yukinoshitaworks/pendulum-clock/cad/README.md

# おもり式 振り子時計 — CADデータ

HTMLシミュレーターと同じ設計スクリプトから書き出したデータです。シミュレーターに映っている形状は、このCADを三角形メッシュにしたものです。

**実機での動作は未確認です。** 歯のかみ合い・部品同士の干渉・脱進機の動きは計算で確認していますが、はめあいの公差、摩擦、おもりの重さは印刷後の調整が前提です。

## 中身

- `pendulum_clock_assembly.step` — 組立状態の全体モデル（12:00:00、鐘を打った直後の姿勢）。部品名つき。Fusion の「アップロード」または「挿入」で開けます。約22 MBあります。
- `parts_step/` — 印刷部品ごとのSTEP（印刷する向きで、底面が Z=0）
- `parts_stl/` — 同じ向きのSTL。そのままスライサーに入れられます
- `extras/anchor_deep_0.2` `anchor_deep_0.4` `anchor_shallow_0.2`（`.step` `.stl`）— 深さ違いのアンクル。脱進機が空回りするときは deep、引っかかって止まるときは shallow に替える（10月28日の節）。
- `extras/fit_test_coupon.step` `.stl` — 穴の試し刷り用の板（圧入穴 φ3.35〜3.55、ベアリングのポケット φ10.30〜10.50 を5段ずつ、径を彫ってある）。本番の前に刷って、ちょうどよい径を選ぶ
- `source/` — 生成に使った Python（CadQuery）スクリプト。歯数や寸法を変えて再生成できます。`fit_test.py` は試し刷り用の板を作る

## 主な仕様

| 項目 | 値 |
|---|---|
| 振り子 | 周期 1 秒（支点から振り玉中心まで約 250 mm、ナットで調整） |
| 脱進機 | グラハム式デッドビート、ガンギ車 30 枚（先端径 60 mm）、7.5 歯またぎ、リフト 1.5°／ロック 1.5°／ドロップ 2.75°（歯先の幅 0.8 mm、前の面の逃げ 12°、歯の背に段） |
| 輪列 | 一番車 60 → カナ 24、二番車 96 → カナ 8、三番車 80 → ガンギカナ 8（インボリュート、圧力角 20°、m1.5 / m1.0） |
| 日の裏 | 筒カナ 12 → 日の裏車 36、カナ 10 → 筒車 40（m1.0 / m0.96） |
| 動力 | 巻胴 φ47、2.5 時間で 1 回転。ひも約 9.8 巻きで約 24.5 時間（毎日巻く）、降下量 約 1.49 m。おもり 1〜1.5 kg |
| 鐘 | 二番軸の渦巻きカムがハンマーを 1 時間かけて持ち上げ、正時に 1 回打つ（時の数は打ち分けません） |
| 地板間 | 36 mm、地板厚 5 mm |

## 印刷部品（36 種、合計 約 463 cm³）

最大の部品は `back_plate`（166 × 198 mm）で、220 × 220 mm のベッドに収まります。おもり容器は高さ 200 mm です。

| ファイル | 部品 | 個数 | 寸法 mm | 体積 cm³ |
|---|---|---|---|---|
| `back_plate` | 後ろ地板（ベル支柱つき） | 1 | 166 × 198 × 42 | 58 |
| `front_plate` | 前地板 | 1 | 131 × 198 × 5 | 47 |
| `pillar_36_x4` | 地板間ピラー (36 mm) | 4 | 10 × 10 × 36 | 2 |
| `rear_standoff_30_x4` | 背面スタンドオフ (30 mm) | 4 | 10 × 10 × 30 | 2 |
| `front_spacer_16_x2` | 上側の前スペーサ (16.2 mm)（M3 全ねじ 100 mm の余りを受ける） | 2 | 10 × 10 × 16 | 1 |
| `wall_frame` | 壁掛けフレーム | 1 | 131 × 176 × 6 | 46 |
| `great_wheel` | 一番車 60枚 (m1.5) | 1 | 93 × 93 × 14 | 25 |
| `click_plate` | コハゼ板（一体ばね爪×3） | 1 | 59 × 59 × 10 | 7 |
| `drum_core` | 巻胴（ラチェットつき） | 1 | 55 × 55 × 17 | 25 |
| `drum_front` | 巻胴 前フランジ（六角巻き軸） | 1 | 55 × 55 × 22 | 8 |
| `centre_wheel` | 二番車 96枚＋カナ24枚 | 1 | 97 × 97 × 22 | 25 |
| `spacer_C_rear` | スペーサ 1.7 mm | 1 | 5 × 5 × 2 | 0 |
| `strike_cam` | 打鐘カム（1時間で1回転の渦巻き） | 1 | 27 × 23 × 12 | 3 |
| `third_wheel` | 三番車 80枚＋カナ8枚 | 1 | 81 × 81 × 20 | 10 |
| `spacer_T_front` | スペーサ 15.2 mm | 1 | 5 × 5 × 15 | 0 |
| `escape_wheel` | ガンギ車 30枚＋カナ8枚 | 1 | 60 × 60 × 27 | 6 |
| `spacer_E_rear` | スペーサ 8.7 mm | 1 | 5 × 5 × 9 | 0 |
| `anchor` | アンクル（グラハム式デッドビート） | 1 | 60 × 29 × 27 | 4 |
| `spacer_A_rear` | スペーサ 8.2 mm | 1 | 5 × 5 × 8 | 0 |
| `cannon_pinion` | 筒カナ 12枚（摩擦で軸に固定） | 1 | 14 × 14 × 22 | 1 |
| `minute_wheel` | 日の裏車 36枚＋カナ10枚 | 1 | 37 × 37 × 11 | 4 |
| `collar_x2` | 抜け止めカラー | 2 | 7 × 7 × 3 | 0 |
| `hour_wheel` | 筒車 40枚（時針） | 1 | 40 × 40 × 12 | 4 |
| `minute_hand` | 長針 | 1 | 13 × 98 × 2 | 1 |
| `hour_hand` | 短針 | 1 | 16 × 67 × 2 | 1 |
| `dial_ring` | 文字盤リング | 1 | 176 × 176 × 4 | 28 |
| `dial_standoff_12_x2` | 文字盤スタンドオフ (12 mm) | 2 | 10 × 10 × 12 | 1 |
| `dial_post_top` | 文字盤ポスト 12時側 (下穴φ2.8) | 1 | 8 × 8 × 12 | 0 |
| `hammer` | ハンマー（尾がカムに乗る） | 1 | 87 × 52 × 12 | 4 |
| `pendulum_hanger_left` | 振り子ハンガー 左半分（ねじの頭の側） | 1 | 17 × 41 × 8 | 5 |
| `pendulum_hanger_right` | 振り子ハンガー 右半分（ナットの側） | 1 | 17 × 41 × 8 | 5 |
| `bob_rear` | 振り玉 φ70 後ろ半分（ピンつき・接着） | 1 | 70 × 70 × 10 | 26 |
| `bob_front` | 振り玉 φ70 前半分（接着） | 1 | 70 × 70 × 8 | 23 |
| `rating_nut` | 歩度調整ナット（M4ナット内蔵） | 1 | 18 × 18 × 9 | 2 |
| `weight_shell` | おもり容器 φ50×200（鉄球などを充填） | 1 | 50 × 50 × 200 | 65 |
| `winding_key` | 巻きカギ（六角10 mm） | 1 | 60 × 19 × 29 | 10 |

印刷の目安: ノズル 0.4 mm、積層 0.2 mm（歯車は 0.12〜0.16 mm が無難）、外周 3 周以上。歯車と脱進機まわりは反りの少ない PLA、コハゼ板（ばね爪）は折れにくい PETG を推奨。サポートは不要な向きにしてあります（振り玉とハンガーは横穴のサポートが取りにくかったため、10月17日に前後2つに分けました）。巻胴の後ろフランジ裏だけ約 54° の張り出しがあります。

## 別途用意するもの

| 品目 | 数量 | 用途 |
|---|---|---|
| ミニチュアベアリング 623ZZ（3×10×4） | 8 | 二番・三番・ガンギ・アンクルの各軸。グリスは洗い流して軽い油を一滴。購入先の例：[Amazon](https://amzn.asia/d/0f9G3Mzo) |
| φ3 丸棒（ステンレスか磨き鋼、5 mm 刻みの定尺品） | 70 / 65 / 55 / 55 / 45 / 45 / 20 / 20 mm 各1 | 順に 二番軸、アンクル軸、一番軸、おもりのひも掛け（50 mm でも可）、三番軸、ガンギ軸、ハンマー軸、日の裏車の軸。切断不要 |
| M3 全ねじ | 100 mm ×4 | 壁フレーム〜地板（下2本は文字盤まで）を通しで締める。上2本は前に上側の前スペーサを通す |
| M3 ナット | 8 | 上記の両端（壁側は六角ポケットに入れる） |
| M3×12 皿タッピング | 3 | 巻胴の前後をつなぐ（下穴 φ3.1） |
| M3×10 皿ねじ | 2 | 文字盤 12 時側ポストの前後 |
| M3×20 ＋ナット | 3 | 振り子ハンガーの左右を締めて、アンクル軸と振り竿をはさむ |
| M4 全ねじ 285 mm ＋ M4 ナット 2 | 1 | 振り竿。ハンガーに 15 mm 差し込む。ナット1個は歩度調整ナットに埋め込み |
| M6×12 ボルト＋ナット | 1 | ハンマーヘッドの重りと打面 |
| 金属ベルのドーム φ55〜60（自転車ベルや卓上ベル）＋ M4×10 | 1 | 鐘。樹脂で印刷しても鳴りません |
| 伸びにくい細ひも φ1 mm 前後 | 約 1.9 m | おもり用 |
| 鉄球・散弾・砂鉄など | 約 1.5 kg | おもりの中身。振り玉のポケットには硬貨やナット |
| 木ねじ | 2 | 壁フレーム上部の φ4.7 穴 |
| 接着剤（瞬間接着剤か2液エポキシ） | 少量 | 振り玉の前後の半分を貼り合わせる |

## 組立の順番

1. 前後の地板のポケットにベアリングを圧入する（内側の面から。ポケットは φ10.4）。
2. 各歯車を丸棒に圧入する。二番軸は後ろから スペーサ1.7 → 二番車 → 打鐘カム。三番軸は 三番車 → スペーサ15.2。ガンギ軸は スペーサ8.7 → ガンギ車。アンクル軸は スペーサ8.2 → アンクル。穴は φ3.4 で、手で強めに押して入るのが目安。ゆるければ瞬間接着剤で留める（筒カナは針合わせで軸の上を滑らせるので接着しない）。
3. 巻胴の前後を皿ねじ3本でつなぎ、ひもの端を前フランジの小穴に通して結ぶ。一番車の穴にコハゼ板のピンを差し、巻胴のラチェットをコハゼ板の中に入れる。前から見て巻胴を時計回りに回すと空回り（カチカチ鳴る）、反時計回りで一番車が連れ回れば正しい向き。
4. 後ろ地板に一番軸（φ3×55）を、後ろ端が地板の裏面とそろうまで圧入し、一番車 → コハゼ板 → 巻胴の順に通す。ほかの軸も後ろ地板のベアリングに立てる。
5. 前地板にハンマー軸と日の裏車の軸を圧入し、ハンマーを通してカラーで抜け止めする。ピラー4本を挟んで前地板をかぶせる。巻胴の六角軸は前地板の大穴から出る。
6. 壁フレーム（裏のポケットにナット）→ 背面スタンドオフ → 後ろ地板 → ピラー → 前地板 の順に M3 全ねじを通す。4本とも 100 mm で、後ろ端はポケットのナットの裏面とそろえる。上2本は前地板の前に 上側の前スペーサ を通してからナットを締める。下2本はさらに 文字盤スタンドオフ → 文字盤 を通して締める。12 時側ポストは前地板の内側から皿ねじで留める。
7. 前地板の前に 筒カナ（二番軸に摩擦で留まる）→ 日の裏車＋カラー → 筒車 を入れ、短針・長針を差す。
8. 振り玉は後ろ半分（ピン2本つき）と前半分を接着する（接着剤は溝から 2 mm 以上離す）。振り子ハンガーは接着しない。左右の半分で、上の横溝に後ろ地板の裏に出たアンクル軸を、縦溝に M4 全ねじ（端から 15 mm）をはさみ、M3×20 ねじ 3 本（頭は左、ナットは右）で締める。全ねじの下にもう 1 個のナットを締め、振り玉・調整ナットを付ける。ビートは上の 2 本をゆるめて合わせる。
9. ベルをベル支柱にねじ留めする。ハンマーが落ちきった位置でヘッドとベルのすき間が 0.5〜1 mm になるよう調整する（当たったままだと音が止まる）。
10. 壁に掛け、ひもを巻胴に巻いておもりを吊る。ひもは前から見て巻胴の左側から下ろす。巻きカギは文字盤の6時の巻き穴から六角軸に差す。長針が6時付近（25〜35分）にあるとカギの胴に当たるので、よけてから巻く。

## 定尺品への置き換え（2026年10月12日）

丸棒と全ねじは、手に入る定尺品の長さに合わせて CAD を直しました。印刷部品の形は変わらず、上側の前スペーサ 2 個だけを追加しています。

| 部品 | 元の設計 | 使う定尺 | 扱いと影響 |
|---|---|---|---|
| アンクル軸 | φ3×64 | 65 | 後ろへ 1 mm 長く出す（壁フレームまで約 10 mm） |
| 一番軸 | φ3×57 | 55 | 後ろ地板への圧入は 5 mm のまま。前端が巻胴の六角軸の中で終わる |
| おもりのひも掛け | φ3×52 | 55（50 も可） | 55 は両端が約 2.5 mm ずつ出る（振り玉とのすき間 4.75 mm）。50 は両端が容器の外面とそろうので接着して抜け止め |
| 三番軸・ガンギ軸 | φ3×44 | 45 | 後ろ端を後ろ地板の裏面とそろえる |
| ハンマー軸 | φ3×21（20.5） | 20 | 前地板の前面とそろえて圧入。カラーは軸の先端とそろえる |
| M3 全ねじ 上2本 | 86 | 100 | 前の余り約 15 mm を、印刷の上側の前スペーサ（16.2 mm）で受ける |
| M3 全ねじ 下2本 | 101 | 100 | ナットの外に約 1.2 mm 出る。元の長さでは先端が長針に触れる寸法だった（すき間 0 → 0.9 mm） |
| M4 全ねじ（振り竿） | 290 | 285 | ハンガーへの差し込みを 20 → 15 mm にして、下端と歩度の調整範囲を設計どおりに保つ |

二番軸（70 mm）と日の裏車の軸（20 mm）は元の設計どおりです。

## 振り玉とハンガーの分割（2026年10月17日）

振り玉とハンガーの横向きの穴（振り竿の穴、ハンガーの締めねじの穴）は、そのまま刷ると穴の中にサポート材が入って取りにくかったため、穴の中心を通る面で前後に分けました。どちらの半分も分割面を上にして刷ると、穴は上に開いた半円の溝になり、サポート材は要りません（STL で下向きの面がないことを確認）。後ろ半分に位置合わせのピン（φ3、高さ 2 mm）が 2 本あり、前半分の穴（φ3.6。10月22日に φ3.2 から広げた）に差して接着します。合わせた形と穴の寸法は分割前と同じです。

## 穴の寸法の見直し（2026年10月12〜23日）

最初の印刷で穴が全体にきつかったため、穴の寸法を次のように変えました。外形と歯形は変えていません。変わらないのは `click_plate` だけなので、ほかの 33 種は刷り直してください。13 日には六角穴を、17 日には丸棒の圧入穴（φ3.2 → 3.3）とベアリングのポケット（φ10.2 → 10.3）、続いて丸棒の上で回る穴（φ3.5 → 3.6）を広げました。最後の変更で変わるのは `great_wheel`、`drum_core`、`drum_front`、`minute_wheel`、`hammer` の 5 種です。寸法は `source/build_cad.py` の先頭（`ROD_PRESS`、`ROD_FREE`、`BRG_R`、`M3_R`、`TAP3_R`、`TAP4_R`、`X`、`HEX_M3`、`HEX_M4`、`HEX_KEY`）にまとめてあります。

| 穴の種類 | 前 | 今回 | おもな部品 |
|---|---|---|---|
| 丸棒の圧入穴 | φ2.95 / φ3.0 | φ3.4 | 歯車・カム・アンクル・筒カナ・カラー / 地板（一番軸・ハンマー軸・日の裏車の軸）、振り子ハンガー |
| 丸棒の上で回る穴 | φ3.3 | φ3.6 | 一番車、巻胴（前後）、日の裏車、ハンマー |
| ベアリングのポケット | φ10.1 | φ10.4 | 前後の地板（623ZZ） |
| M3 の通し穴 | φ3.4 | φ3.5 | 地板、ピラー、スタンドオフ、前スペーサ、壁フレーム、文字盤、巻胴の前フランジ |
| ねじの下穴 | φ2.6 / φ3.3・3.4 | φ2.8 / φ3.5 | M3 タッピング（巻胴、文字盤ポスト。巻胴は 28 日に φ3.1） / M4（ベル支柱、ハンガーの振り竿。振り竿は 23 日に φ3.7、26 日に φ3.9、30 日に φ4.5） |
| ナットと巻きカギの六角穴（二面幅） | 5.8・7.2・10.4 | 5.9・7.3・10.5 | 壁フレームの M3 ナット、歩度調整ナットの M4 ナット、巻きカギ（13 日に変更） |
| そのほかの穴 | — | +0.2 | 丸棒に通すスペーサ φ3.4、筒車 φ6.6、長針の D 穴、短針 φ9.2、一番車のピン穴 φ5.4、前地板の巻胴軸の穴 φ12.6、ハンガーの締めねじ φ3.5、振り玉 φ5.0、歩度調整ナット φ4.8（23 日に +0.2）、ハンマーヘッドの M6 φ6.5、おもりのひも掛け φ3.5、壁掛けの木ねじ φ4.7 |

確認：全 65 部品で干渉ゼロ（10月17日の分割後は 67 部品）。軸・ねじと穴の全組のすき間と、ベアリング穴・下穴・六角穴の寸法を測って、上の表どおりであることを確認しました。

## 仮組みを受けた変更（2026年10月21日）

**穴**：Creality K1 と純正 Hyper PLA-CF での仮組みで、圧入穴（φ3.3）とベアリングのポケット（φ10.3）がまだ入らなかった。K1 は小さい穴ほど小さめに出ることが報告されている（PLA の実測例で φ10 → 9.65、φ6 → 5.58、φ4 → 3.26 mm）。炭素繊維入り PLA は熱収縮が小さく、穴が痩せるおもな原因は外周の押し出し幅のほう。φ3.6 の回る穴は使えたことと合わせ、圧入穴を φ3.45、ポケットを φ10.4 にした。スライサー（Creality Print）の「X-Y穴補正」は 0 のままにする（CAD で補正済みなので二重になる）。

**試し刷り**：`extras/fit_test_coupon.stl`（92 × 42 × 5 mm、約 17 cm³）を本番の前に刷る。丸棒が手で強めに押して入る穴と、ベアリングが指で押し込める穴を選び、`source/build_cad.py` の `ROD_PRESS` と `BRG_R` をその値にして `python3 build_cad.py all` で作り直す。

**巻き上げ**：巻きカギの胴（φ19）が文字盤の内縁に 2.5 mm 食い込み、取っ手が目盛りの 0.6 mm 上を回っていた。文字盤の6時に巻き穴（φ22）を開け、巻きカギの胴を 22 → 29 mm に延ばした。取っ手は文字盤と針より前（z 64.6〜70.6）を回る。カギを差して1周回し、文字盤とのすき間 1.5 mm、前地板と 0.6 mm を確認した。

この変更で変わるのは `back_plate`、`front_plate`、`centre_wheel`、`strike_cam`、`third_wheel`、`escape_wheel`、`anchor`、`cannon_pinion`、`collar_x2`、`pendulum_hanger_rear`、`pendulum_hanger_front`、`dial_ring`、`winding_key` の 13 種。

**位置合わせのピン（10月22日）**：振り玉とハンガーの前半分にあるピンの穴（φ3.2）も、K1 では刷るとピン（φ3）より細くなるため、φ3 の丸棒が回ったのと同じ φ3.6 にした。変わるのは `bob_front` と `pendulum_hanger_front` の 2 種。

**圧入穴（10月23日）**：φ3.45 では圧入にはゆるかったため、φ3.4 にした。変わるのは `back_plate`、`front_plate`、`centre_wheel`、`strike_cam`、`third_wheel`、`escape_wheel`、`anchor`、`cannon_pinion`、`collar_x2`、`pendulum_hanger_rear`、`pendulum_hanger_front` の 11 種。

**アンクルと振り子の M4（10月23日）**：アンクルは圧入が 27 mm と長く、きつすぎた。圧入を爪の部分（6 mm）だけにし、筒の部分は φ3.6 の逃げにした。振り子の M4 の穴は 0.2 mm 広げた（ハンガーのねじ込み穴 φ3.5 → 3.7、振り玉 φ4.8 → 5.0、歩度調整ナット φ4.6 → 4.8）。ベル支柱の M4 下穴は φ3.5 のまま。変わるのは `anchor`、`bob_rear`、`bob_front`、`pendulum_hanger_rear`、`pendulum_hanger_front`、`rating_nut` の 6 種。

**ラチェットと輪列（10月23日、組立後）**：組み立てた実機で、おもりの力で巻胴のラチェットが逆転し、おもり 1 kg ではガンギ車が回らなかった。

- ラチェット：爪を受ける歯の面が半径方向にまっすぐ立っていて、おもりの力が爪を外へ押し出す向きに働き、爪を押さえていたのは細いばね腕だけだった。歯の面を 12° の返し（アンダーカット）にし、力がかかるほど爪が歯の根元へ引き込まれる形にした。歯の深さ 2.5 → 3.0 mm（歯先 r15.0 → 15.5）。コハゼ板の爪は返しに沿った形にし、ばね腕の幅を 1.6 → 1.8 mm にした。
- 輪列：一番車 72 枚・二番カナ 12 枚（6 倍）を、中心距離 63 mm のまま 63 枚・21 枚（3 倍）にした。ガンギ車に届く力は 2 倍になり、おもり 1 kg で理論値 0.56 N·mm（これまでの 1.5 kg では 0.42 N·mm）。代わりに巻胴は 3 時間で 1 回転になり、ひも 9 巻きで動く時間は約 54 → **約 27 時間**（毎日 1 回巻く）。二番車から先の歯数は振り子の周期で決まるので変えていない。
- 二番カナが大きくなったので、二番車の肉抜き穴をカナの外側からにした（カナが穴の上に張り出してサポートが要る形になるのを避けた）。
- 変わるのは `great_wheel`、`centre_wheel`、`drum_core`、`click_plate` の 4 種。ほかの 32 種の STL は前回とバイト単位で同じ。コハゼ板のばね腕は巻くたびにしなるので、PETG で刷ると割れにくい。
- 動かないときは、ガンギ・三番・アンクルのベアリング（623ZZ）に入っているグリースを洗い落とし、軽い油を一滴差すと摩擦がかなり減る。おもりは容器いっぱい（約 1.5 kg）まで増やせる。

## 力と脱進機の見直し（2026年10月26日）

条件：連続 24 時間以上動くこと、おもりの降下量 1.5 m 以下。

**巻胴と歯車**：ガンギ車に届く力は「おもりが 1 時間に下がる量」で決まる（巻胴の半径 ÷ 一番車→二番カナの比 に比例。どちらで稼いでも同じ）。条件からの上限は 1.5 m ÷ 24 h ＝ 毎時 62.5 mm。

- 巻胴 φ40 → φ47（ひもの中心の半径 20.5 → 24.0 mm）、フランジ φ47 → φ55。
- 一番車・二番カナ 63・21 → 60・24 枚（中心距離 63 mm のまま、かみ合い率 1.67）。巻胴は 2.5 時間で 1 回転。
- 下がる速さ 毎時 42.9 → 60.3 mm。ガンギ車に届く力 1.41 倍（1 kg で理論値 0.56 → 0.78 N·mm）。
- ひも約 9.8 巻き（φ1 mm なら 1 段目 7 巻き＋2 段目 2.8 巻き）で降下量 約 1.49 m、約 24.5 時間。ひもは約 1.9 m。おもりの底は、いちばん下がったとき文字盤の中心から約 1.85 m 下になる。
- 二番カナが大きくなったので、二番車の肉抜き穴はさらに外側から。

**脱進機**：2D で 1 往復ずつ動かし、すき間と刷りの誤差への強さを調べた。

- 振り子がもどるとき、入り爪の角が、いま外れた歯の背中から 0.26 mm のところを通っていた。ガンギ車とアンクルが 0.1 mm 太く刷れると、ガンギ車の止まる位置も後ろへずれるので、すき間がなくなって噛んだ（計算上）。
- 歯の背中の上 1.2 mm を半径方向に立て（下は太くして根元の幅 1.74 → 2.11 mm）、ドロップを 2° → 2.25° にした。ガンギ車 0.18 mm・アンクル 0.12 mm 太っても、同じだけ細っても、1 往復で 1 歯ずつ進む。
- リフトを 3° → 2° にした。脱進機が外れるのに要る振れ幅が ±2.25° → ±1.75° になる。
- シミュレーター（摩擦なし）で、動き続けるのに要るおもりは 23 日の版の約 55%（巻胴と歯車で約 7 割、脱進機でさらに約 8 割）。

変わるのは `great_wheel`、`centre_wheel`、`drum_core`、`drum_front`、`escape_wheel`、`anchor` の 6 種。`click_plate` を含むほかの 30 種はそのまま（`weight_shell` は位置が 3.5 mm 左へ動いただけで形は同じ）。

**振り子ハンガーの M4（10月30日）**：振り竿の穴を φ3.9 → 4.5 にした（M4 の外径より大きい。K1 では φ4 前後に刷れる見込み）。全ねじは穴に差し込み、ハンガー下面に締めたナットで固定する。ぐらつくときは接着剤も使う。穴が太くなった分、すぐ横の位置合わせピン（下側）を 0.4 mm 外へ動かした（穴との間の壁 1.15 mm）。変わるのは `pendulum_hanger_rear` と `pendulum_hanger_front` の 2 種。

**振り子ハンガーの M4（10月26日）**：振り竿（M4 全ねじ）をねじ込むハンガーの穴を、さらに 0.2 mm 広げて φ3.7 → 3.9 にした。変わるのは `pendulum_hanger_rear` と `pendulum_hanger_front` の 2 種。振り玉と歩度調整ナットの穴はそのまま。

## 組立後の調整（2026年10月28日）

**脱進機の空回り**：26 日の部品に替えたら、ガンギ車が爪をすり抜けて回るようになった。26 日の歯は先端 1.2 mm の幅が 0.3〜0.5 mm と、押し出し 1 本分より細く、刷ると先が欠けたり短くなったりする。歯が止まる深さ（ロック 1.5° ＝ 0.8 mm）がそれで足りなくなったと考えられる。

- 歯の先端を段の下まで幅 0.8 mm（押し出し 2 本分）にした（`ESC_LAND` 0.5 → 0.8 mm、前面の逃げ 8° → 4°、段より上の背 0° → 4°）。
- ロック 1.5° → 2.0°（1.05 mm）、ドロップ 2.25° → 2.75°（先端を太くした分のすき間）。
- 2D の確認：アンクルが設計より 0.3 mm 近くても 0.4 mm 遠くても、歯の先が 0.2 mm 短くても、ガンギ車 0.08 mm・アンクル 0.05 mm 太くても、1 往復で 1 歯ずつ進む。
- 動き続けるのに要るおもり（シミュレーター、摩擦なし）は 26 日の版より約 3 割多く、23 日の版より約 3 割少ない。

**深さ違いのアンクル**：刷り上がりの差で合わないときのため、`extras/` に `anchor_deep_0.2`・`anchor_deep_0.4`（爪が深い。空回りするとき）と `anchor_shallow_0.2`（浅い。歯が爪に引っかかって止まるとき）を入れた。数字は、アンクルの軸とガンギ車の軸の距離に直した量（mm）。まず標準の `anchor` で試す。

**巻胴のねじ穴**：M3 タッピングを締めるときになめたので、巻胴本体の下穴を φ2.8 → 3.1 にした（`DRUM_TAP_R`）。文字盤ポストの下穴は φ2.8 のまま。

**一番車と二番カナのすき間**：歯の厚みを両方 0.13 mm ずつ薄くし（`Gear(..., bl=0.25)`）、バックラッシュ（ピッチ円上）を 0.24 → 0.50 mm にした。中心距離は 63 mm のまま。かみ合い率 1.67 は変わらない。

変わるのは `great_wheel`、`centre_wheel`、`drum_core`、`escape_wheel`、`anchor` の 5 種。`drum_front` は 26 日の版のまま。

## ロックを浅く（2026年11月2日）

組み直して動くようになったが、約 30 秒で止まった。観察では「おもりの力にムラがある」「歯と爪の先どうしが当たって急に止まる」の 2 つ。力が落ちた瞬間に振れ幅が脱進機の外れる角度に届かず、歯の先が爪の端の角に乗ったまま振り子が戻り、ガンギ車を押し返して止まる、と見ている。

- ロック 2.0° → 1.75°。外れるのに要る振れ幅 ±2.0° → ±1.875°、1 往復で要る力は約 18% 減（計算。シミュレーターでは動き続ける最小のおもりが約 12% 減）。
- 2D の確認：アンクルとの距離のずれ −0.3〜＋0.4 mm（歯先が 0.2 mm 短いとき −0.3〜＋0.3 mm）、ガンギ車 0.08 mm・アンクル 0.05 mm 太っても動く。深さ違いのアンクル 3 つも、それぞれ想定のずれで動く。
- 変わるのは `anchor` と `extras/anchor_*`。`escape_wheel` は同じ形（向きが 0.2° 回っただけ）なので刷り直し不要。
- ムラの出どころ（歯車のきつい所、ひもの段の乗り移り、おもりの接触）は、おもりを外して一番車を手でゆっくり回して確かめる。8 枚カナのかみ合いにきつい所があれば、そのすき間を広げる（案 B）。

## 振り子ハンガーと軸受けの当たり（2026年11月5日）

ロックを浅くしてからは 1 分ほど動くが、振れ幅が少しずつ落ちて止まる。おもりを 1.5 kg にしても、爪と歯にシリコンスプレーを吹いてもほとんど変わらなかった。おもりに比例しない損失（振り子側の擦れ・滑り）か、どこかの擦れを疑った。歯車を手で回すと規則的に音が大きくなる所もある。

**ハンガーを左右に分割**：ハンガーを、アンクル軸（z 方向）と振り竿（y 方向）の両方を通る面 x = 0 で左右に分け、M3×20 ねじ 3 本で両方の軸をはさむ形にした。

- すり割り 1 本のクランプで丸い軸をつかむ形では、アンクル軸の上でハンガーが滑り、勢いが逃げてビートもずれていくおそれがあった。
- 半分どうしのあいだに 0.5 mm のすき間を残し、締める力が軸にかかるようにした。溝はアンクル軸 φ3.2、振り竿 φ4.2。φ4.5 の穴でぐらつきやすかった振り竿も、はさんで固定される。
- 接着しない。ビートは上の 2 本をゆるめて合わせる。奥行きは壁側へ 3.5 mm 増やした（z −24〜−7。振り竿をはさむねじの場所）。ナットは外側の面に当てる（ナットのくぼみは、刷るとき台の面に橋渡しができるので付けていない）。

**軸受けへの当たり**：軸受け（623ZZ）に面する部品の端を調べ直したところ、スペーサの端（φ5.4）とアンクル・打鐘カムの筒（φ8）が、内輪（約 φ5.2）より外の、止まっているシールドや外輪に触れる大きさだった。軸が前後に寄るたびに擦れる。とくにアンクルの筒は振り子の勢いを直接奪う。

- 軸受けに面する端すべてに、内輪だけに当たる φ4.6 × 0.6 mm の段を付けた（`SH_R`、`SH_L`）。
- 後ろ側のスペーサ 3 種は、段が上になる向きで刷るように裏返した。

**歯車の規則的な音**：おもりを外して一番車を手でゆっくり回し、音の周期を数えて軸を絞り込む（ガンギ車 1 回転ごとならガンギ軸、三番車 1 回転ごとなら三番軸）。その軸の歯先のバリ、擦れている面、前後の遊び（設計では片側 0.3 mm、合わせて 0.6 mm）を見る。

**脱進機（同日）**：爪が歯を止めている間に振り子がさらに振れると、爪のロック面の角が歯の前の面から 0.005〜0.017 mm しか離れていなかった（10月28日に逃げを 8° → 4° に減らしたため）。

- 歯の前の面の逃げ 4° → 12°（段より上の背も 12° にして、歯先の幅 0.8 mm は保つ）。角と前の面のすき間 0.07〜0.09 mm、歯の背中のすき間 0.42〜0.44 mm。
- リフト 2.0° → 1.5°、ロック 1.75° → 1.5°。外れるのに要る振れ幅 ±1.875° → ±1.5°（振り玉の中心で左右約 6.5 mm）。1 往復で要る力は計算で約 36% 減（シミュレーターでは動き続ける最小のおもり 0.29 → 0.24 kg）。
- アンクルとの距離のずれに耐える範囲 −0.2〜＋0.5 mm（歯先が 0.2 mm 短いとき −0.3〜＋0.2 mm）。ガンギ車 0.08 mm・アンクル 0.05 mm 太っても、0.12・0.08 mm 細っても動く。深さ違いのアンクル 3 つも、それぞれ想定のずれで動く。
- ビートは少しシビアになる。

変わるのは `pendulum_hanger_left`・`pendulum_hanger_right`（`pendulum_hanger_rear`・`_front` と置き換え）、`anchor`（`extras/anchor_*` も）、`escape_wheel`、`strike_cam`、`third_wheel`、`spacer_C_rear`、`spacer_T_front`、`spacer_E_rear`、`spacer_A_rear`。三番車は軸受け側の端だけなので、今の部品の端をやすりで φ4.6 程度に細くしても同じ効果がある。

## 調整

- **ビート合わせ**: 振り子を静止させた位置から左右同じだけ振ったときに「チク」「タク」が鳴るよう、ハンガーの上 2 本のねじをゆるめてアンクルとの角度を合わせる。
- **歩度**: 調整ナットで振り玉を上げると進み、下げると遅れる。1 mm で約 170 秒/日。
- **止まる場合**: 振れ幅が ±1.5°（振り玉の中心で左右約 6.5 mm）を下回ると脱進機が外れなくなる。おもりを増やす、ベアリングの脱脂、歯面のバリ取り、軸の曲がりを確認。
- **針合わせ**: 長針を回すと筒カナが軸の上で滑る。鐘が鳴った瞬間に長針を 12 に合わせると、以後は正時に鳴る。短針は筒車の筒に摩擦で留まっているので個別に回せる。
- **公差**: 圧入穴 φ3.4、遊び穴 φ3.6、ベアリング穴 φ10.4、M3 通し穴 φ3.5、下穴 φ2.8（M3、巻胴は φ3.1）/ φ3.5（M4）、六角穴 5.9（M3 ナット）/ 7.3（M4 ナット）/ 10.5（巻きカギ）、歯のバックラッシ 片側 0.12 mm（一番車と二番カナは 0.25 mm）で作図。穴は `build_cad.py` の先頭、歯は `source/design.py` の `BACKLASH` で変えて再生成できる。

## 既知の割り切り

- 一度巻いて約 24.5 時間なので、毎日巻く（10月23日・26日に、力を優先して 54 時間から短くした）。巻胴の下に約 1.5 m の空きが要る。
- 巻き上げ中は駆動力が抜ける（維持動力なし）。数秒なら振り子は惰性で動き続ける。
- 筒カナの摩擦留めは印刷精度に左右される。滑りすぎるなら軸に薄く接着剤を塗って太らせるか、波ワッシャを追加する。
- カナは 8 枚のインボリュートで、時計用のサイクロイド歯形より効率は落ちる。おもりで補う前提。
