yukinoshitaworks/pendulum-clock/esc.jpg

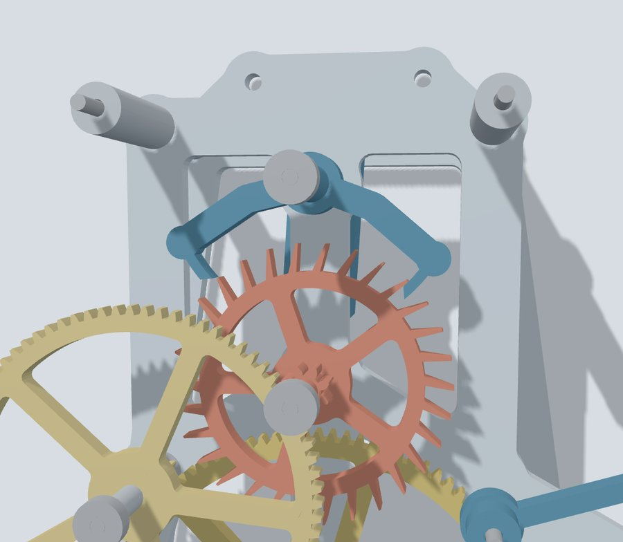
esc.jpg
