yukinoshitaworks/pendulum-clock/cad/pendulum_clock_assembly.step

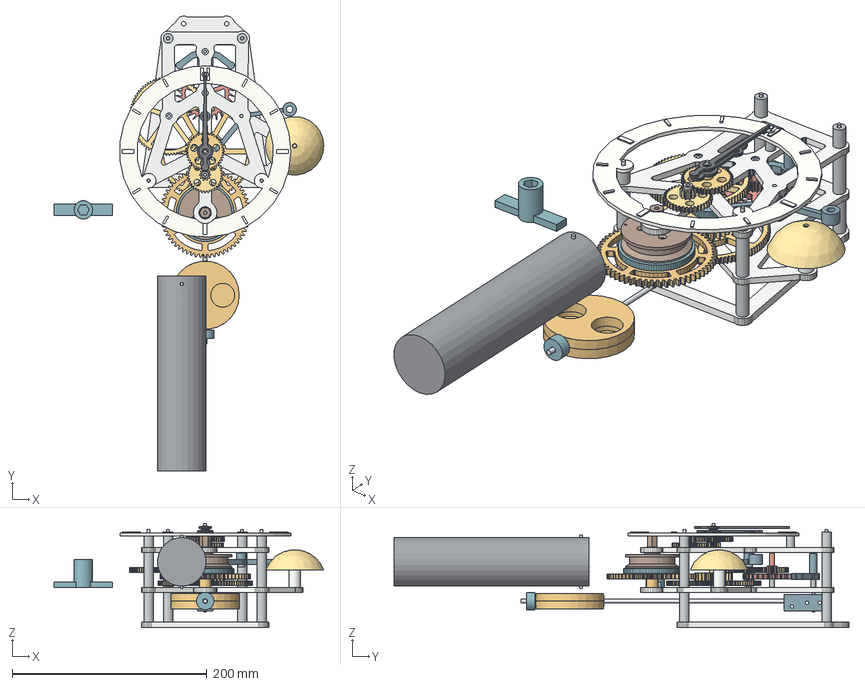
[picture p7: CAD file, 2026-11-04]
cad/pendulum_clock_assembly.step
276.8 x 467.0 x 107.0 mm
back_plate
front_plate
pillar_1
rear_standoff_1
tie_rod_1
front_spacer_1
pillar_2
rear_standoff_2
tie_rod_2
front_spacer_2
pillar_3
rear_standoff_3
tie_rod_3
pillar_4
rear_standoff_4
tie_rod_4
wall_frame
bearing_C_rear
bearing_C_front
bearing_T_rear
bearing_T_front
bearing_E_rear
bearing_E_front
bearing_A_rear
bearing_A_front
rod_C
rod_T
rod_E
rod_A
rod_G
rod_M
rod_H
great_wheel
click_plate
drum_core
drum_front
centre_wheel
spacer_C_rear
strike_cam
third_wheel
spacer_T_front
escape_wheel
spacer_E_rear
anchor
spacer_A_rear
cannon_pinion
minute_wheel
collar_M
hour_wheel
minute_hand
hour_hand
dial_ring
dial_standoff_1
dial_standoff_2
dial_post_top
hammer
collar_H
bell_dome
pendulum_hanger_left
pendulum_hanger_right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
