yukinoshitaworks/pendulum-clock/cad/extras/anchor_deep_0.4.step

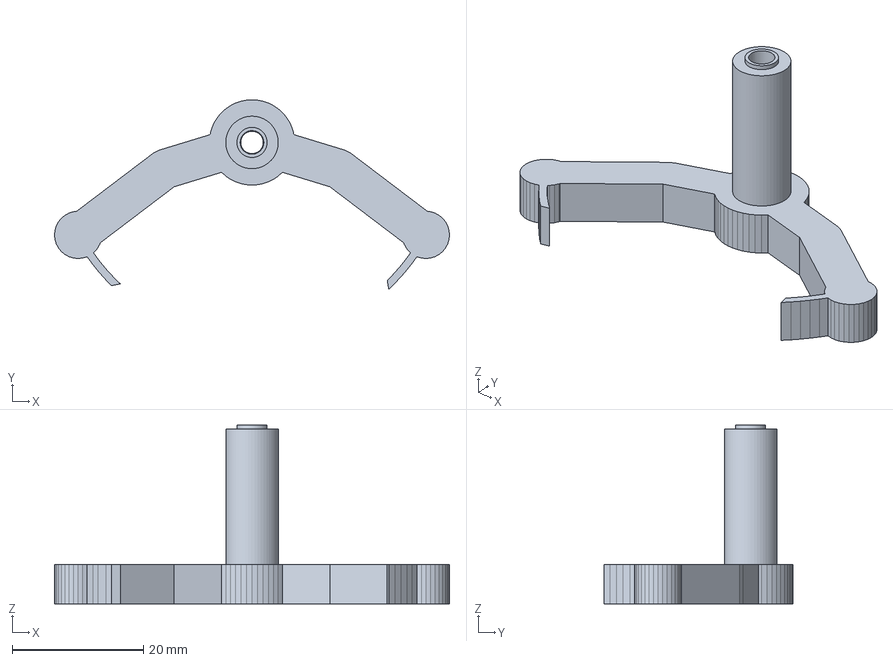
[picture p8: CAD file, 2026-11-04]
cad/extras/anchor_deep_0.4.step
60.2 x 28.9 x 27.2 mm
