yukinoshitaworks/pendulum-clock/cad/parts_step/collar_x2.step

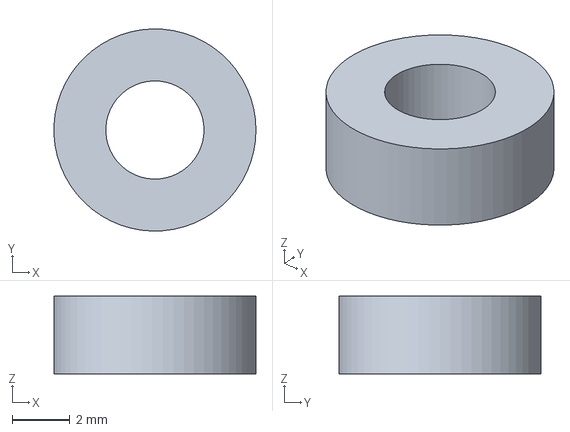
[picture p9: CAD file, 2026-11-04]
cad/parts_step/collar_x2.step
7.00 x 7.00 x 2.70 mm
