yukinoshitaworks/pendulum-clock/cad/extras/fit_test_coupon.step

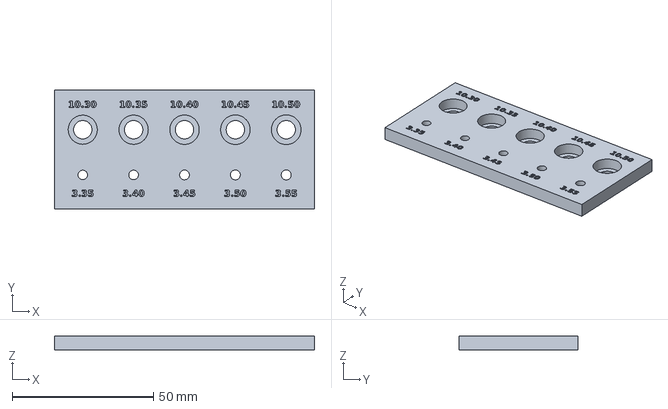
[picture p10: CAD file, 2026-11-04]
cad/extras/fit_test_coupon.step
92.0 x 42.0 x 5.00 mm
