yukinoshitaworks/pendulum-clock/cad/parts_step/hour_wheel.step

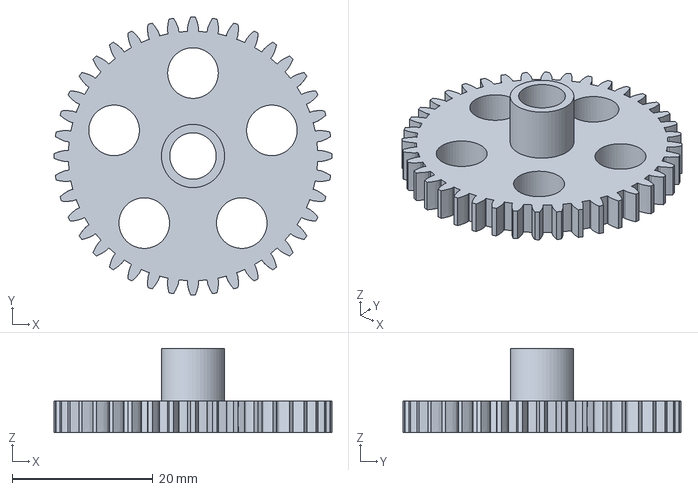
[picture p11: CAD file, 2026-11-04]
cad/parts_step/hour_wheel.step
39.6 x 39.6 x 12.0 mm
