yukinoshitaworks/pendulum-clock/cad/parts_step/pendulum_hanger_right.step

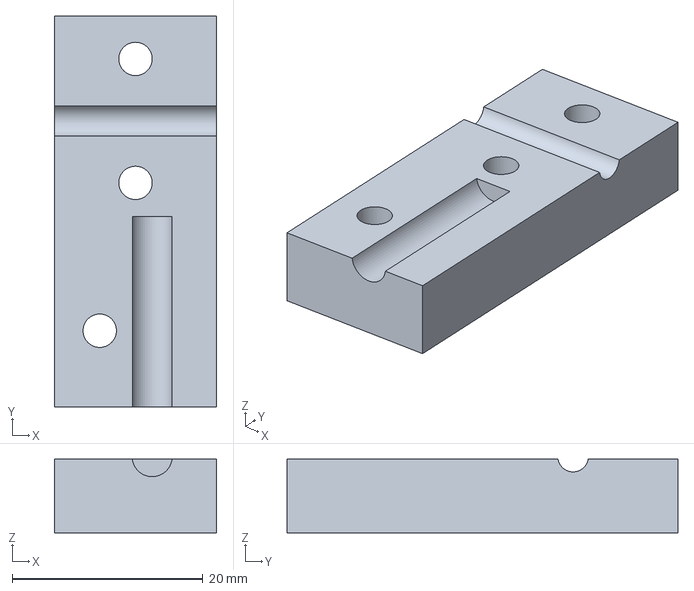
[picture p12: CAD file, 2026-11-04]
cad/parts_step/pendulum_hanger_right.step
17.0 x 41.0 x 7.75 mm
