yukinoshitaworks/pendulum-clock/cad/parts_step/front_spacer_16_x2.step

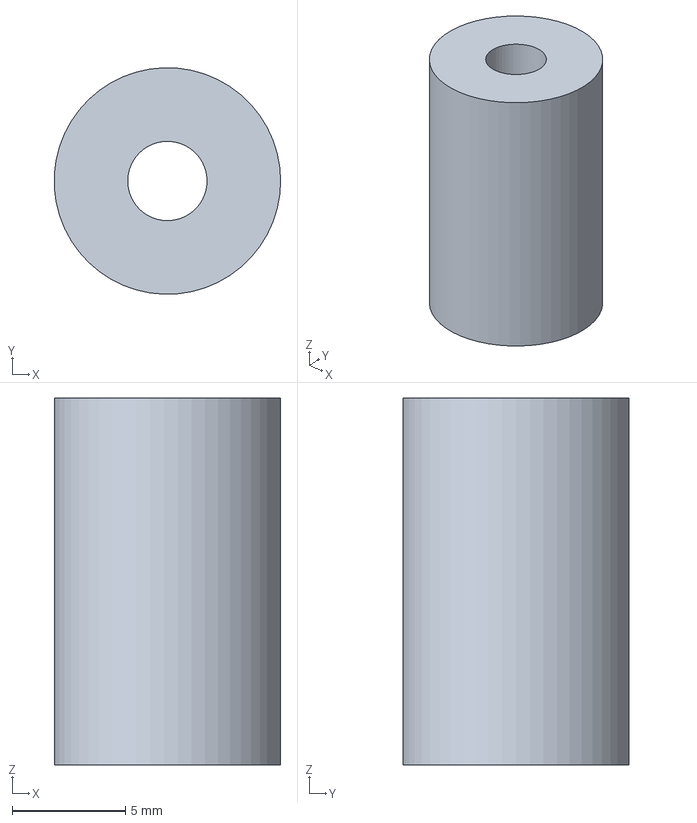
[picture p13: CAD file, 2026-11-04]
cad/parts_step/front_spacer_16_x2.step
9.99 x 10.00 x 16.2 mm
