yukinoshitaworks/pendulum-clock/cad/parts_step/pillar_36_x4.step

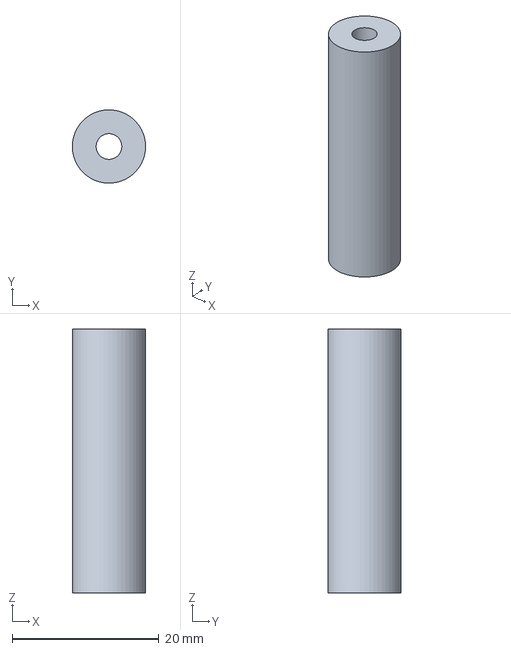
[picture p14: CAD file, 2026-11-04]
cad/parts_step/pillar_36_x4.step
9.99 x 10.00 x 36.0 mm
