yukinoshitaworks/pendulum-clock/cad/parts_step/spacer_E_rear.step

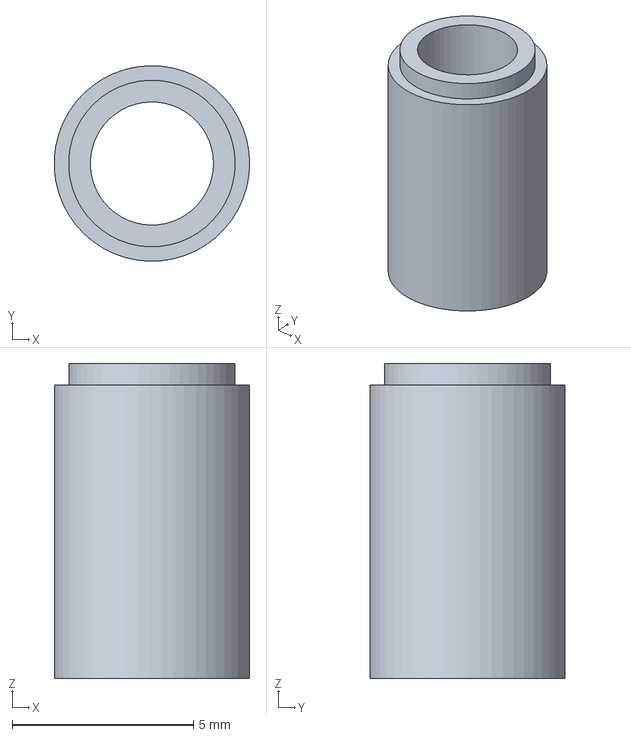
[picture p15: CAD file, 2026-11-04]
cad/parts_step/spacer_E_rear.step
5.39 x 5.40 x 8.70 mm
