yukinoshitaworks/pendulum-clock/cad/parts_step/escape_wheel.step

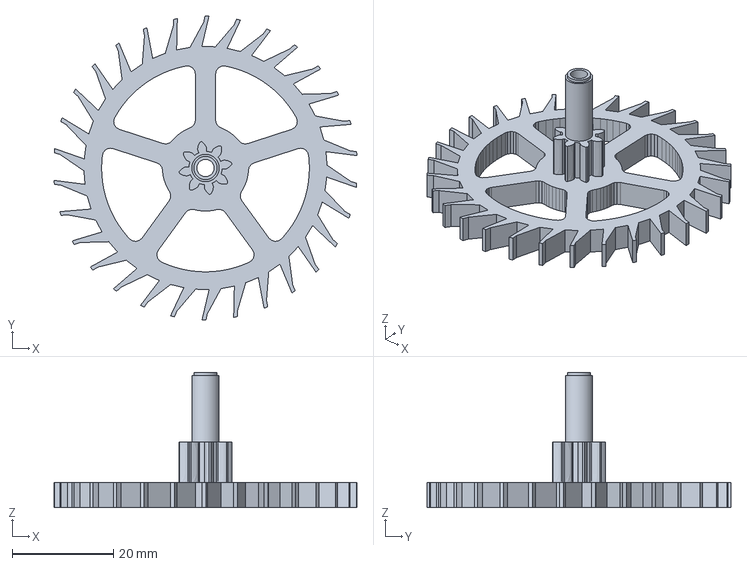
[picture p16: CAD file, 2026-11-04]
cad/parts_step/escape_wheel.step
59.8 x 60.0 x 26.7 mm
