yukinoshitaworks/pendulum-clock/cad/parts_step/spacer_T_front.step

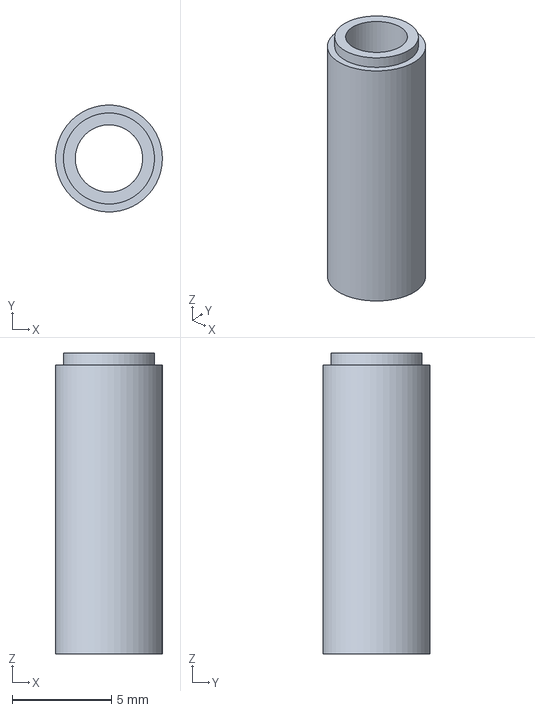
[picture p17: CAD file, 2026-11-04]
cad/parts_step/spacer_T_front.step
5.39 x 5.40 x 15.2 mm
