yukinoshitaworks/pendulum-clock/cad/parts_step/front_plate.step

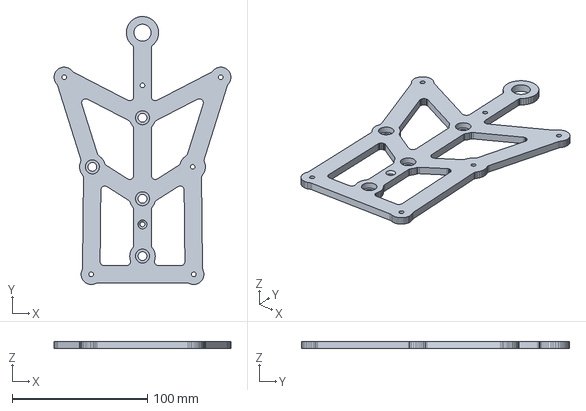
[picture p18: CAD file, 2026-11-04]
cad/parts_step/front_plate.step
131.0 x 198.5 x 5.00 mm
