yukinoshitaworks/pendulum-clock/cad/parts_step/third_wheel.step

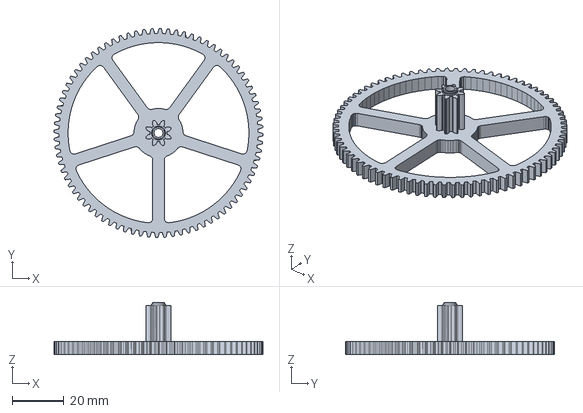
[picture p19: CAD file, 2026-11-04]
cad/parts_step/third_wheel.step
80.9 x 80.9 x 20.2 mm
