yukinoshitaworks/pendulum-clock/cad/parts_step/bob_rear.step

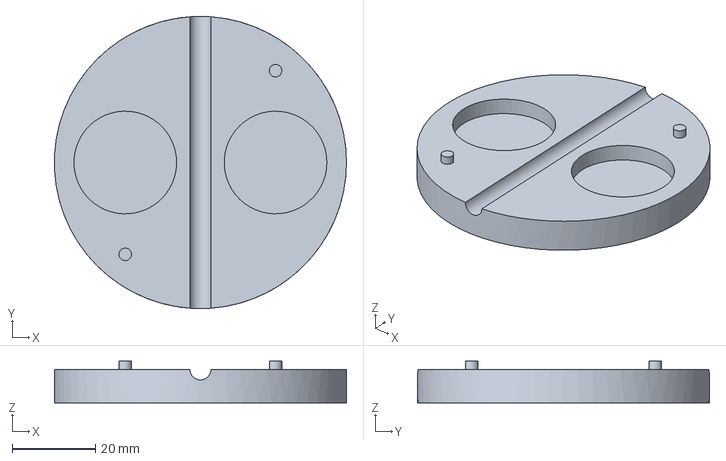
[picture p20: CAD file, 2026-11-04]
cad/parts_step/bob_rear.step
70.0 x 70.0 x 10.00 mm
