yukinoshitaworks/pendulum-clock/cad/parts_step/drum_front.step

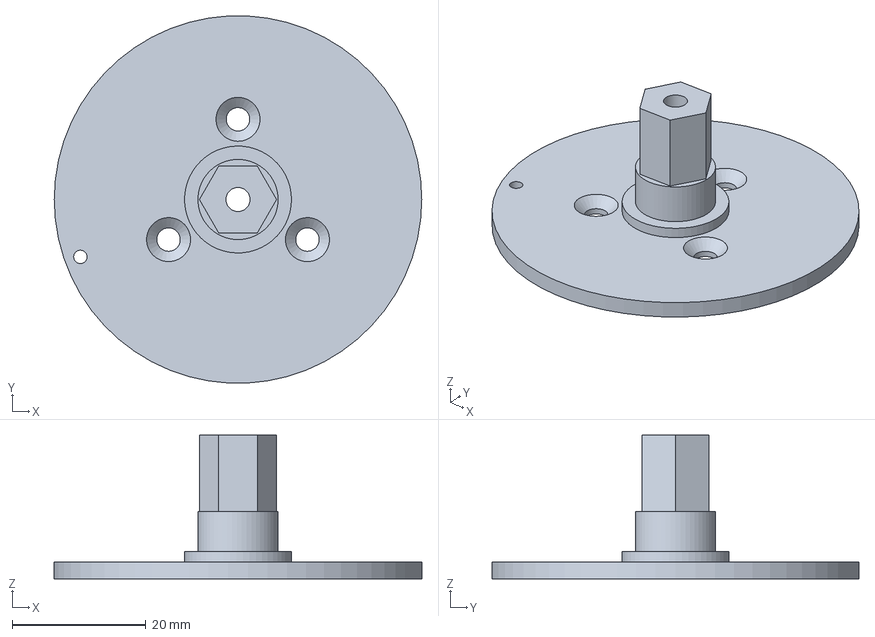
[picture p21: CAD file, 2026-11-04]
cad/parts_step/drum_front.step
55.0 x 54.9 x 21.5 mm
