yukinoshitaworks/pendulum-clock/cad/parts_step/wall_frame.step

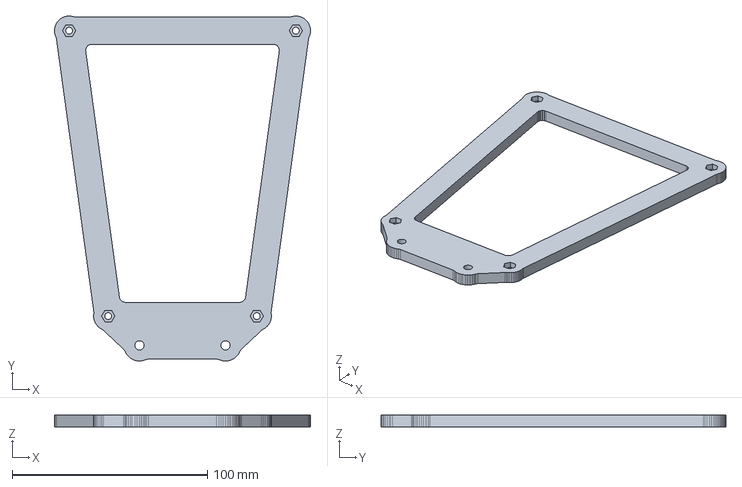
[picture p22: CAD file, 2026-11-04]
cad/parts_step/wall_frame.step
131.0 x 176.5 x 6.00 mm
