yukinoshitaworks/pendulum-clock/cad/parts_step/bob_front.step

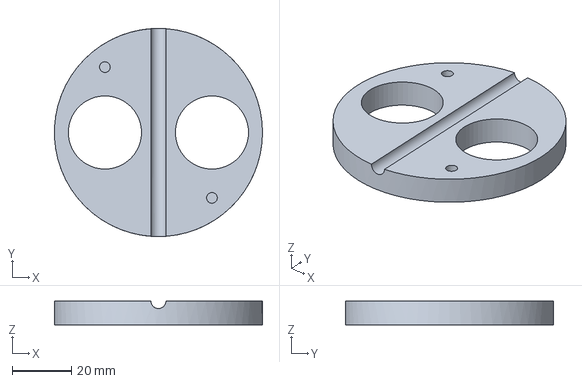
[picture p23: CAD file, 2026-11-04]
cad/parts_step/bob_front.step
70.0 x 70.0 x 8.00 mm
