yukinoshitaworks/pendulum-clock/cad/parts_step/click_plate.step

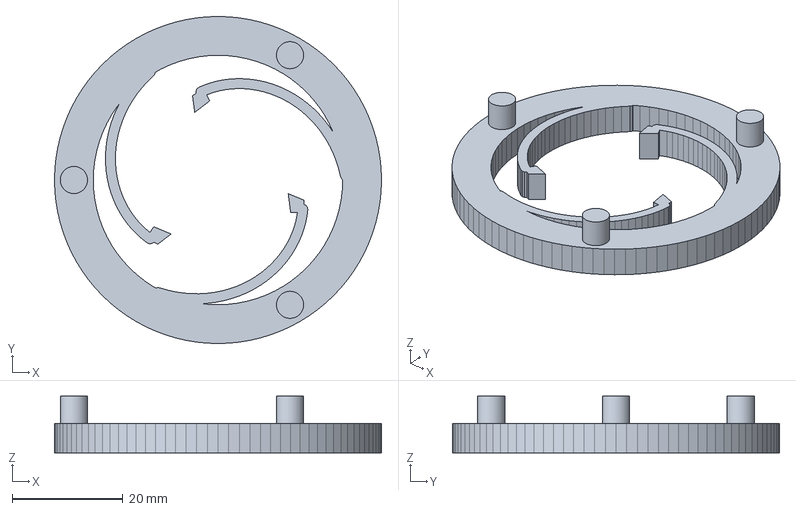
[picture p24: CAD file, 2026-11-04]
cad/parts_step/click_plate.step
59.0 x 59.0 x 10.2 mm
