yukinoshitaworks/pendulum-clock/cad/parts_step/centre_wheel.step

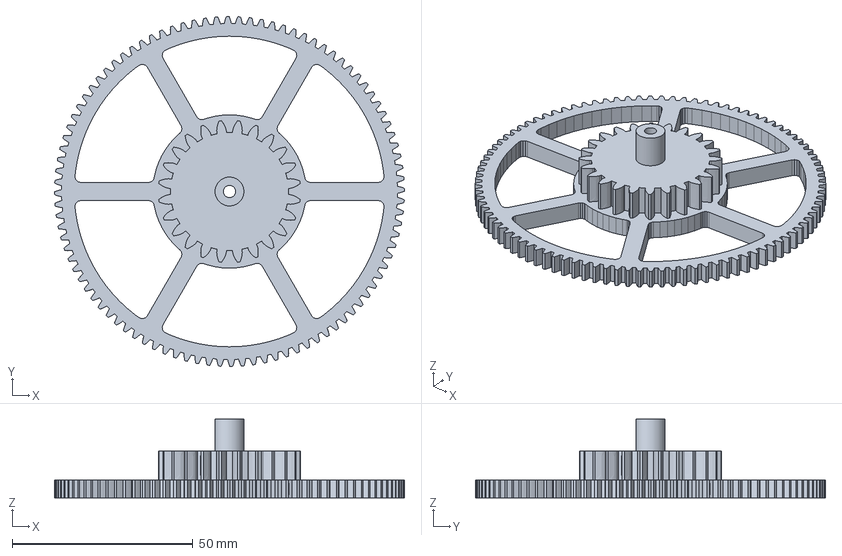
[picture p25: CAD file, 2026-11-04]
cad/parts_step/centre_wheel.step
96.9 x 96.9 x 21.8 mm
