yukinoshitaworks/pendulum-clock/cad/parts_step/hammer.step

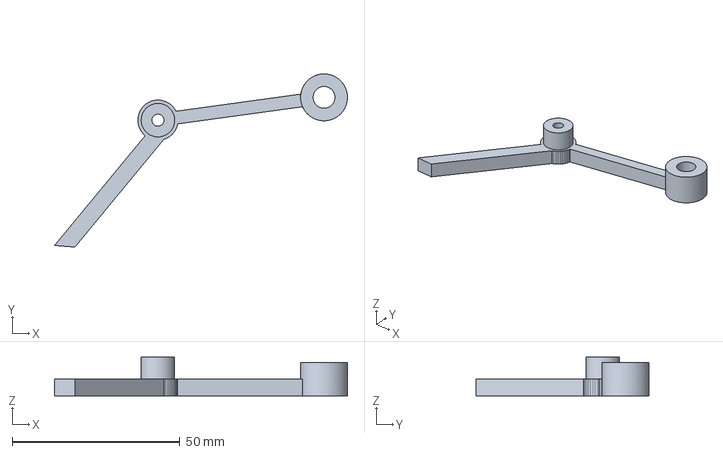
[picture p26: CAD file, 2026-11-04]
cad/parts_step/hammer.step
87.4 x 51.7 x 11.6 mm
