yukinoshitaworks/pendulum-clock/cad/parts_step/back_plate.step

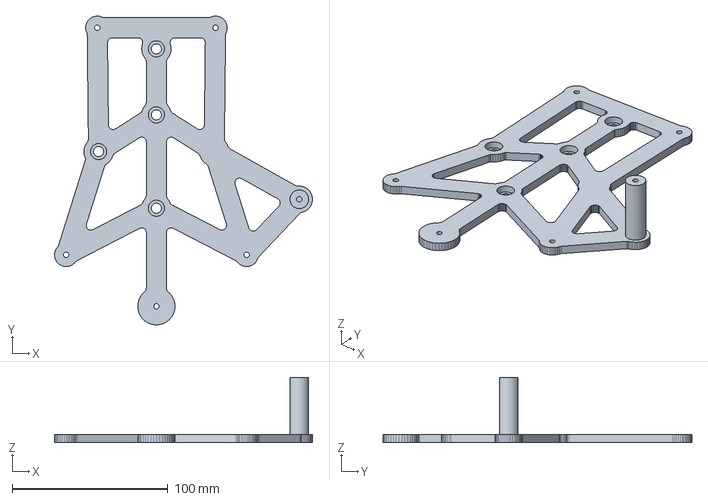
[picture p27: CAD file, 2026-11-04]
cad/parts_step/back_plate.step
165.8 x 198.5 x 41.8 mm
