yukinoshitaworks/pendulum-clock/cad/parts_step/dial_post_top.step

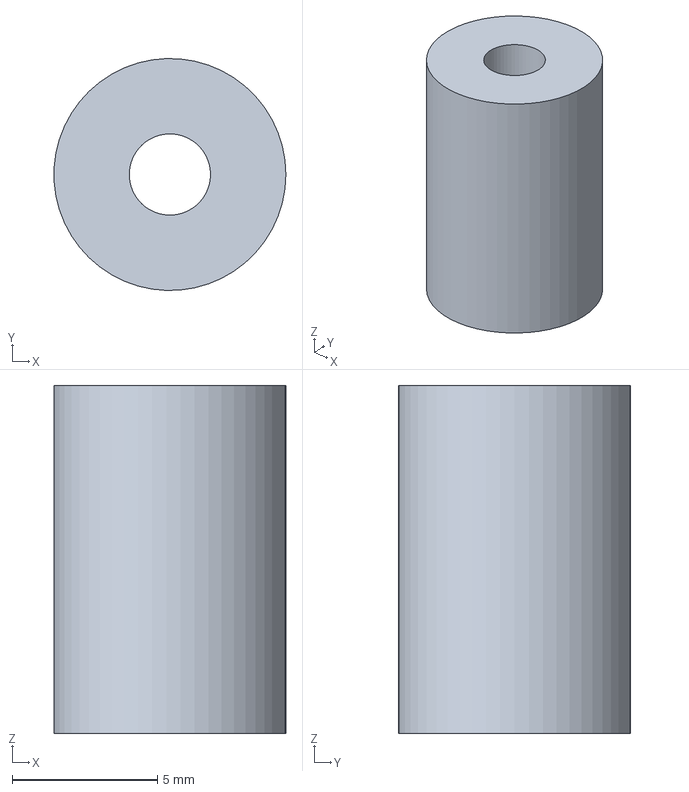
[picture p28: CAD file, 2026-11-04]
cad/parts_step/dial_post_top.step
7.99 x 8.00 x 12.0 mm
