yukinoshitaworks/pendulum-clock/cad/parts_step/hour_hand.step

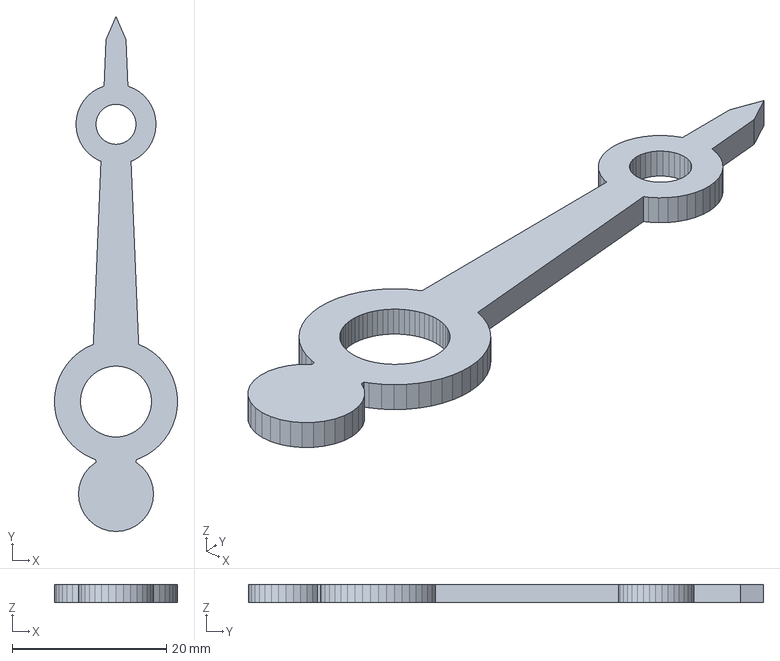
[picture p29: CAD file, 2026-11-04]
cad/parts_step/hour_hand.step
16.0 x 66.9 x 2.40 mm
