yukinoshitaworks/pendulum-clock/cad/parts_step/dial_ring.step

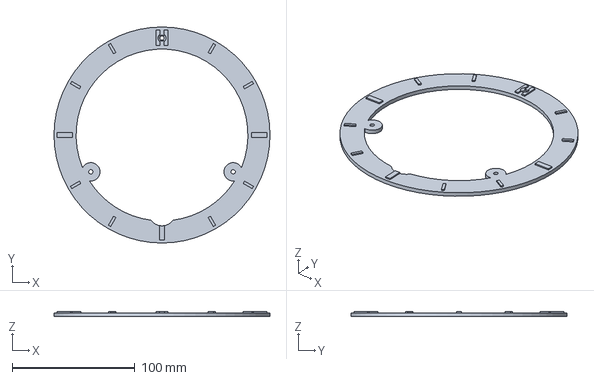
[picture p30: CAD file, 2026-11-04]
cad/parts_step/dial_ring.step
176.0 x 176.0 x 4.00 mm
