yukinoshitaworks/pendulum-clock/cad/parts_step/cannon_pinion.step

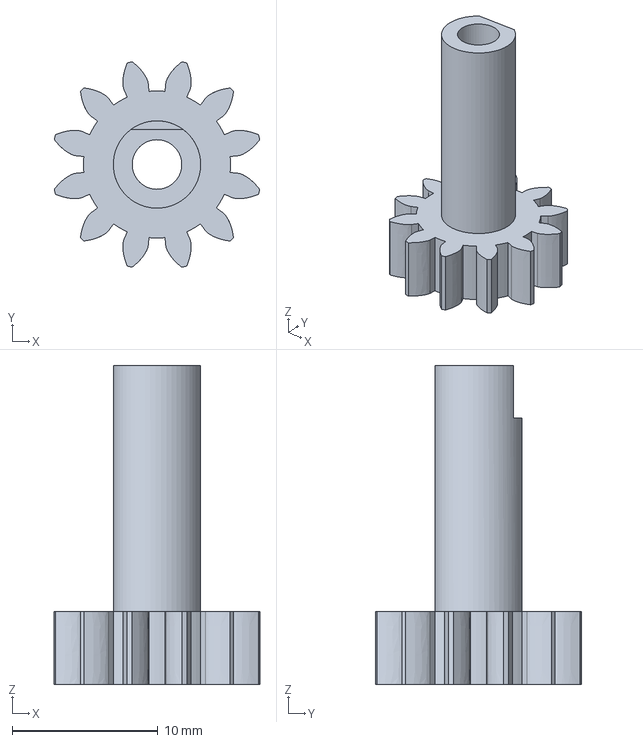
[picture p31: CAD file, 2026-11-04]
cad/parts_step/cannon_pinion.step
14.1 x 14.1 x 21.9 mm
