yukinoshitaworks/pendulum-clock/cad/parts_step/spacer_A_rear.step

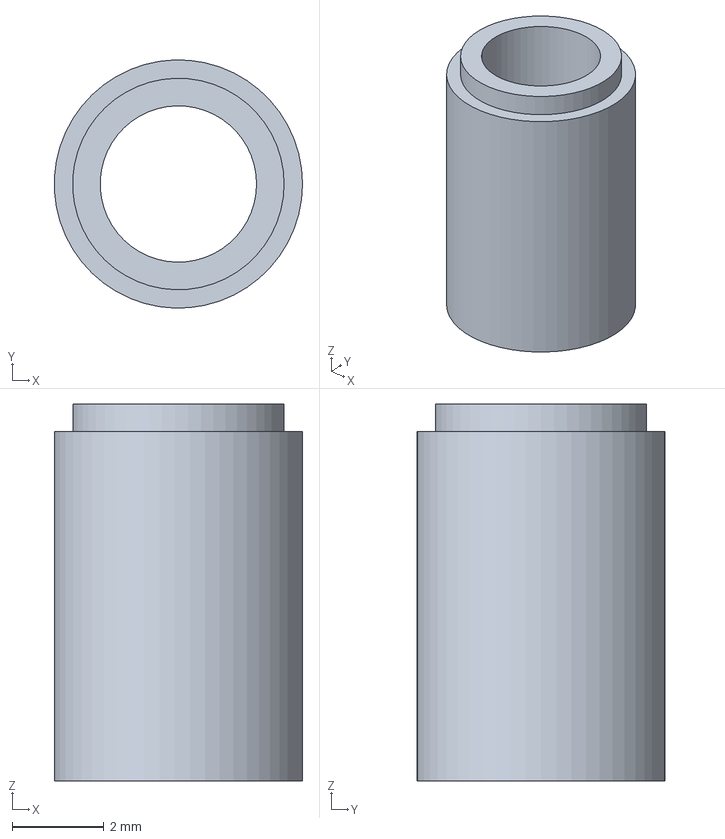
[picture p32: CAD file, 2026-11-04]
cad/parts_step/spacer_A_rear.step
5.39 x 5.40 x 8.20 mm
