yukinoshitaworks/pendulum-clock/cad/parts_step/rear_standoff_30_x4.step

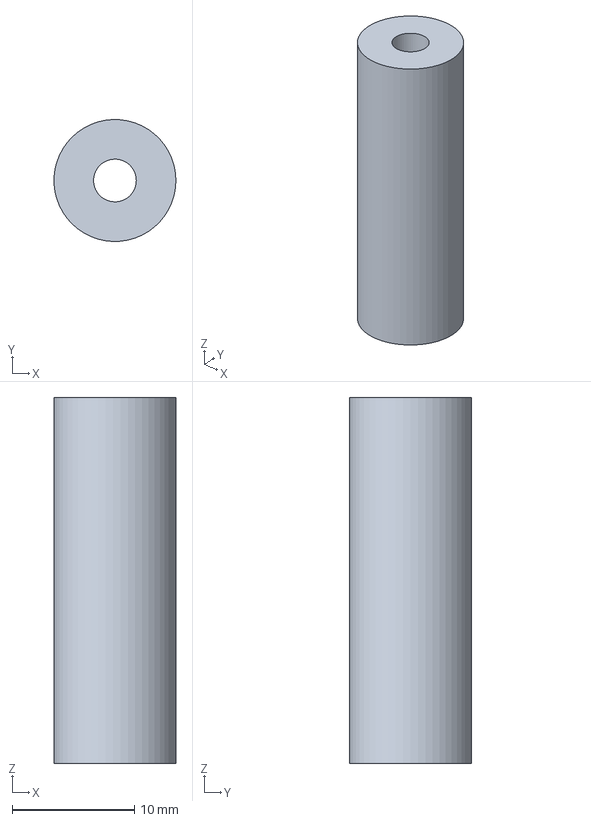
[picture p33: CAD file, 2026-11-04]
cad/parts_step/rear_standoff_30_x4.step
9.99 x 10.00 x 30.0 mm
