yukinoshitaworks/pendulum-clock/cad/parts_step/great_wheel.step

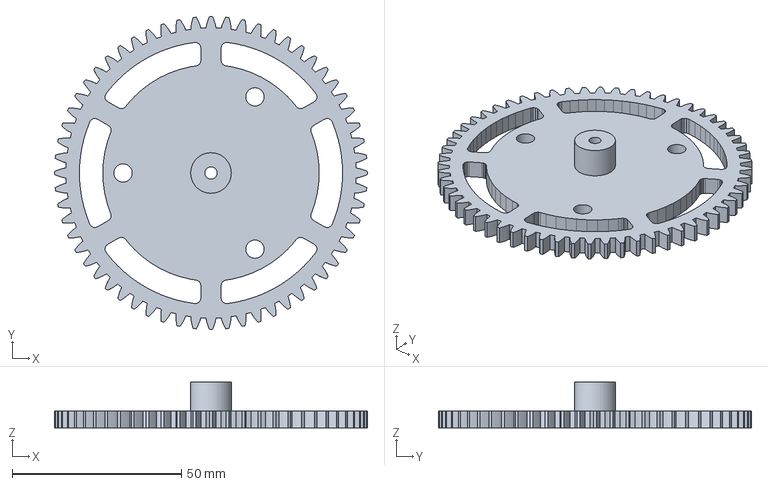
[picture p34: CAD file, 2026-11-04]
cad/parts_step/great_wheel.step
92.5 x 92.5 x 13.6 mm
