yukinoshitaworks/pendulum-clock/cad/parts_step/spacer_C_rear.step

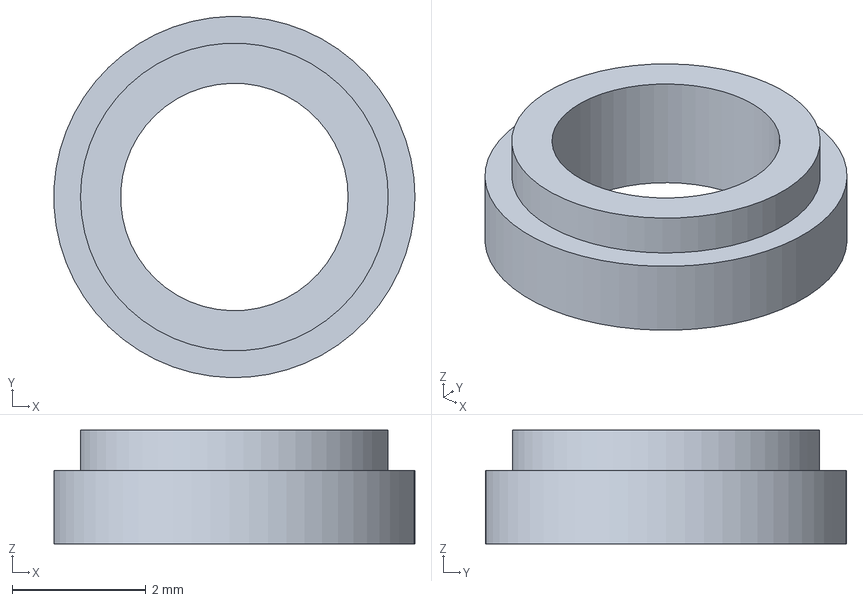
[picture p35: CAD file, 2026-11-04]
cad/parts_step/spacer_C_rear.step
5.40 x 5.40 x 1.70 mm
