yukinoshitaworks/pendulum-clock/cad/parts_step/minute_hand.step

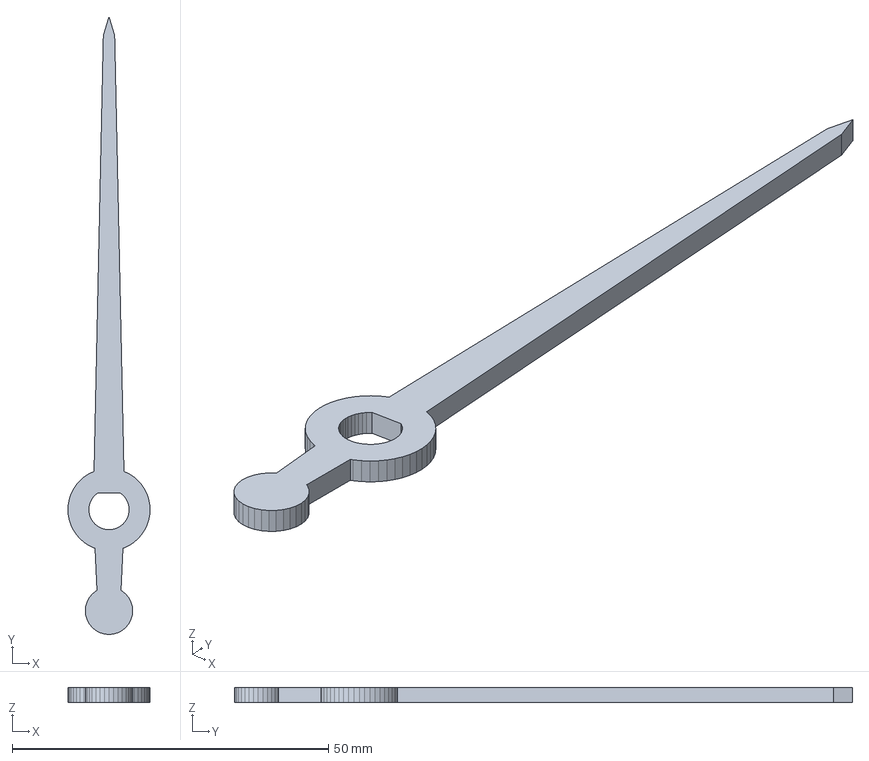
[picture p36: CAD file, 2026-11-04]
cad/parts_step/minute_hand.step
13.0 x 97.8 x 2.40 mm
