yukinoshitaworks/pendulum-clock/cad/parts_step/drum_core.step

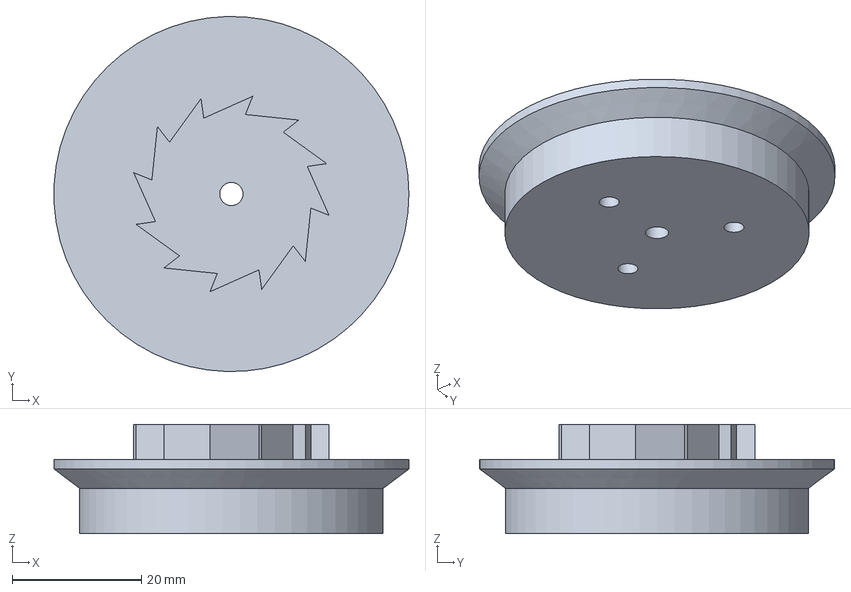
[picture p37: CAD file, 2026-11-04]
cad/parts_step/drum_core.step
55.0 x 55.0 x 16.9 mm
