yukinoshitaworks/pendulum-clock/cad/parts_step/strike_cam.step

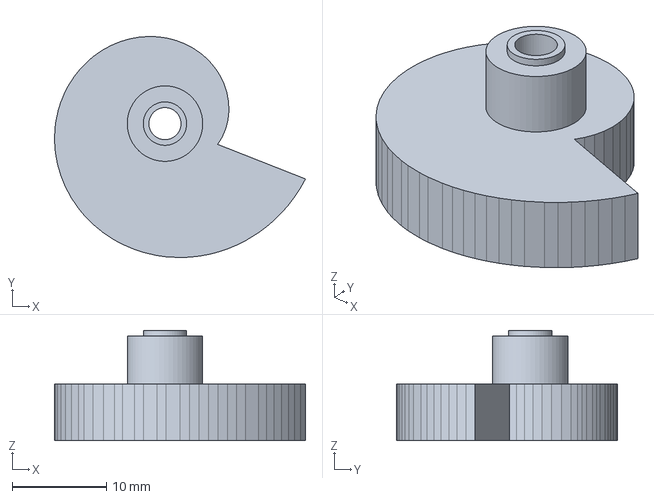
[picture p38: CAD file, 2026-11-04]
cad/parts_step/strike_cam.step
26.6 x 23.4 x 11.7 mm
