yukinoshitaworks/pendulum-clock/cad/parts_step/minute_wheel.step

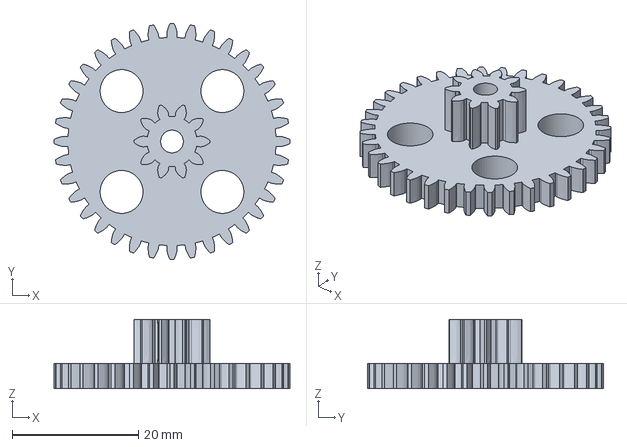
[picture p39: CAD file, 2026-11-04]
cad/parts_step/minute_wheel.step
37.4 x 37.4 x 11.0 mm
