yukinoshitaworks/pendulum-clock/cad/parts_step/weight_shell.step

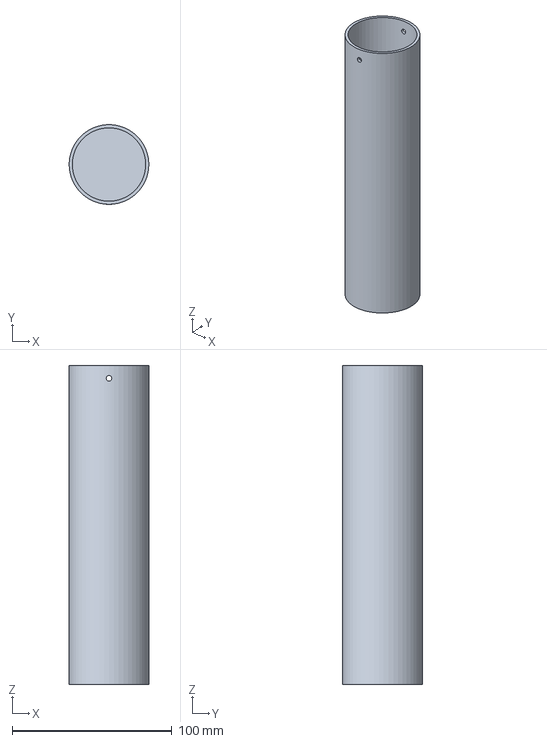
[picture p40: CAD file, 2026-11-04]
cad/parts_step/weight_shell.step
50.0 x 50.0 x 200.0 mm
