yukinoshitaworks/pendulum-clock/cad/parts_step/winding_key.step

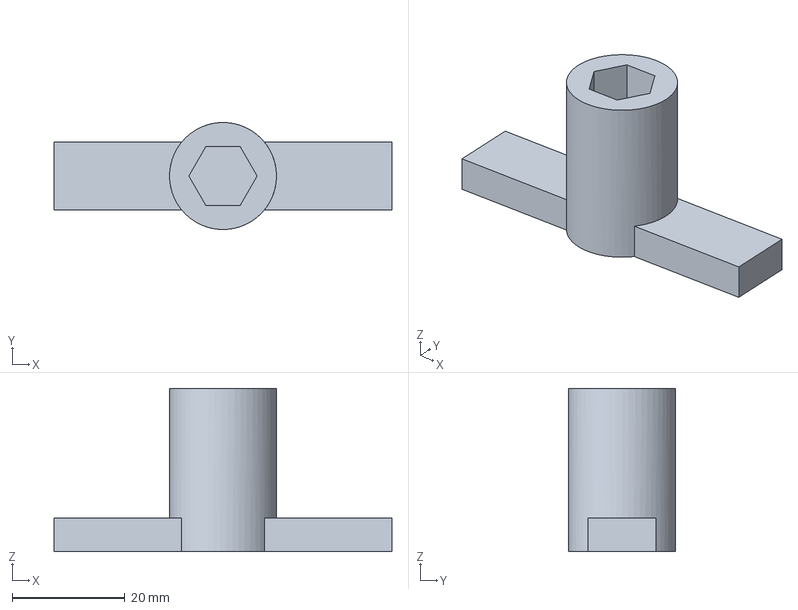
[picture p41: CAD file, 2026-11-04]
cad/parts_step/winding_key.step
60.0 x 19.0 x 29.0 mm
