yukinoshitaworks/pendulum-clock/cad/parts_step/dial_standoff_12_x2.step

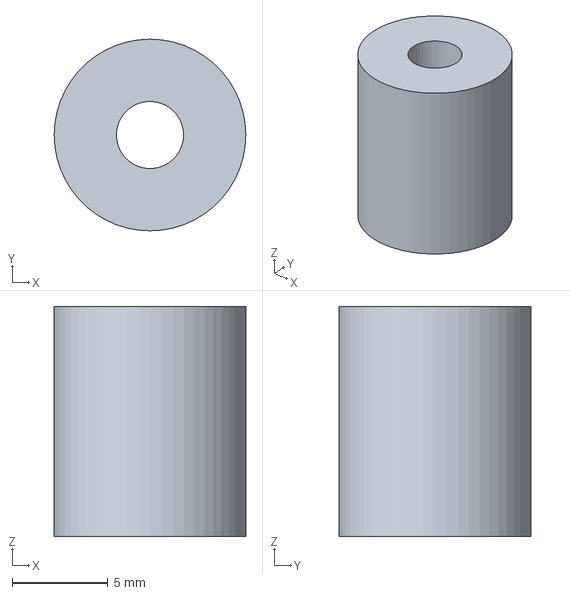
[picture p42: CAD file, 2026-11-04]
cad/parts_step/dial_standoff_12_x2.step
10.0 x 10.0 x 12.0 mm
