yukinoshitaworks/pendulum-clock/cad/parts_step/pendulum_hanger_front.step

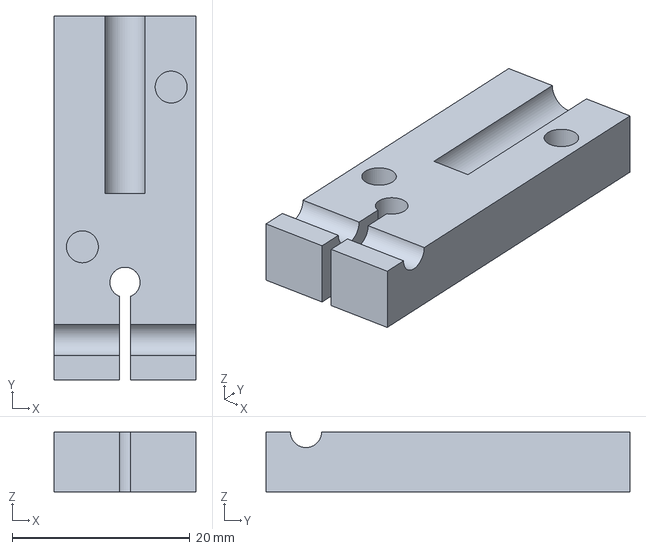
[picture p43: CAD file, 2026-11-02]
cad/parts_step/pendulum_hanger_front.step
16.0 x 41.0 x 6.75 mm
