yukinoshitaworks/pendulum-clock/cad/parts_step/pendulum_hanger_rear.step

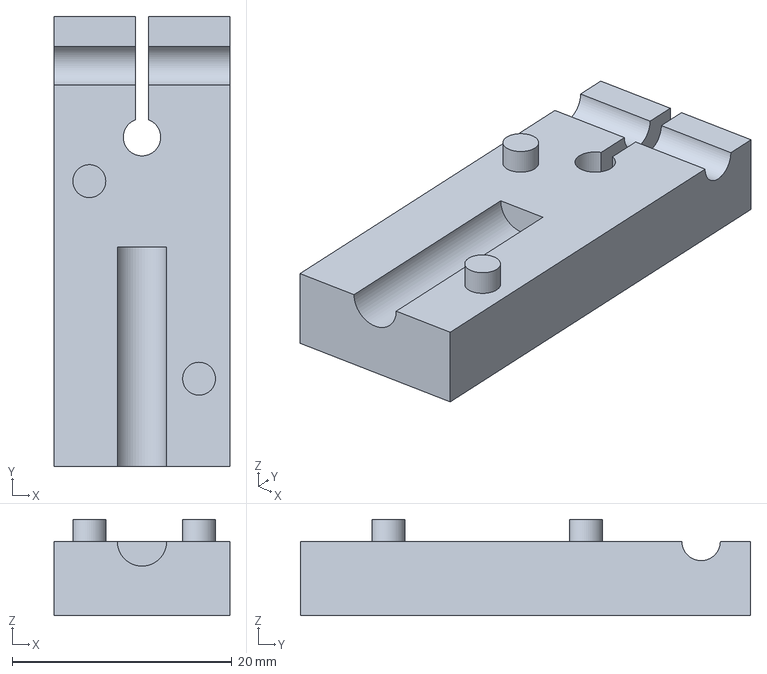
[picture p44: CAD file, 2026-11-02]
cad/parts_step/pendulum_hanger_rear.step
16.0 x 41.0 x 8.75 mm
