yukinoshitaworks/pendulum-clock/cad/parts_step/pendulum_hanger.step

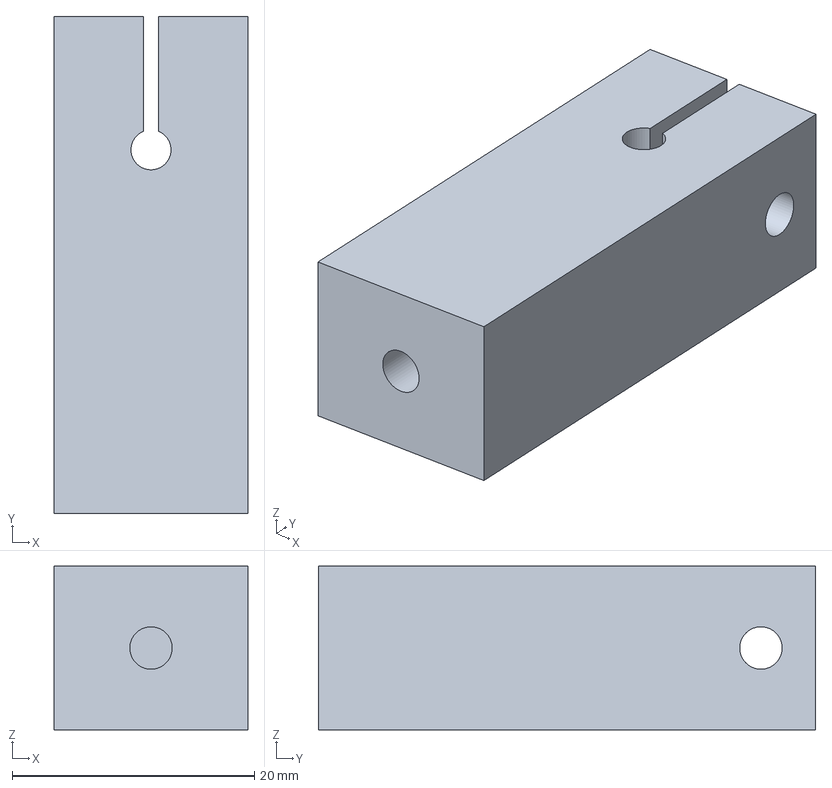
[picture p45: CAD file, 2026-10-17]
cad/parts_step/pendulum_hanger.step
16.0 x 41.0 x 13.5 mm
