yukinoshitaworks/pendulum-clock/cad/parts_step/bob.step

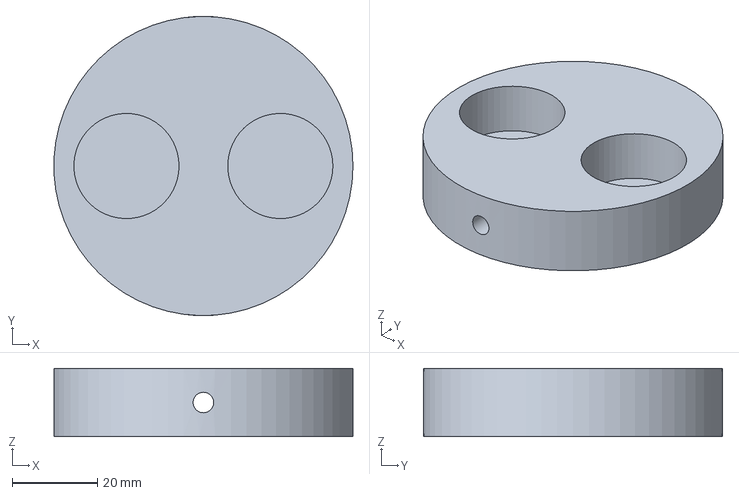
[picture p46: CAD file, 2026-10-17]
cad/parts_step/bob.step
70.0 x 70.0 x 16.0 mm
