yukinoshitaworks/pendulum-clock/(list of files, cad)

Other CAD files:
cad/extras/anchor_shallow_0.2.step
cad/extras/anchor_deep_0.2.step
cad/parts_step/anchor.step
cad/parts_step/pendulum_hanger_left.step
cad/extras/anchor_deep_0.2.stl
cad/extras/anchor_deep_0.4.stl
cad/extras/anchor_shallow_0.2.stl
cad/extras/fit_test_coupon.stl
cad/parts_step/rating_nut.step
cad/parts_stl/anchor.stl
cad/parts_stl/back_plate.stl
cad/parts_stl/bob.stl
cad/parts_stl/bob_front.stl
cad/parts_stl/bob_rear.stl
cad/parts_stl/cannon_pinion.stl
cad/parts_stl/centre_wheel.stl
cad/parts_stl/click_plate.stl
cad/parts_stl/collar_x2.stl
cad/parts_stl/dial_post_top.stl
cad/parts_stl/dial_ring.stl
cad/parts_stl/dial_standoff_12_x2.stl
cad/parts_stl/drum_core.stl
cad/parts_stl/drum_front.stl
cad/parts_stl/escape_wheel.stl
cad/parts_stl/front_plate.stl
cad/parts_stl/front_spacer_16_x2.stl
cad/parts_stl/great_wheel.stl
cad/parts_stl/hammer.stl
cad/parts_stl/hour_hand.stl
cad/parts_stl/hour_wheel.stl
cad/parts_stl/minute_hand.stl
cad/parts_stl/minute_wheel.stl
cad/parts_stl/pendulum_hanger.stl
cad/parts_stl/pendulum_hanger_front.stl
cad/parts_stl/pendulum_hanger_left.stl
cad/parts_stl/pendulum_hanger_rear.stl
cad/parts_stl/pendulum_hanger_right.stl
cad/parts_stl/pillar_36_x4.stl
cad/parts_stl/rating_nut.stl
cad/parts_stl/rear_standoff_30_x4.stl
cad/parts_stl/spacer_A_rear.stl
cad/parts_stl/spacer_C_rear.stl
cad/parts_stl/spacer_E_rear.stl
cad/parts_stl/spacer_T_front.stl
cad/parts_stl/strike_cam.stl
cad/parts_stl/third_wheel.stl
cad/parts_stl/wall_frame.stl
cad/parts_stl/weight_shell.stl
cad/parts_stl/winding_key.stl
