yukinoshitaworks/pendulum-clock/(commit log)

2026-10-17 丸棒を定尺品に、嵌め合いを修正
2026-10-17 Add pendulum clock simulator, CAD (STEP/STL, source) and Japanese manual
    Hole sizes from the first test prints (rod press 3.2, running 3.5, bearing 10.2,
    M3 clearance 3.5, pilots 2.8/3.5, hexes 5.9/7.3/10.5) and stock rod lengths.
    Claude-Session: https://claude.ai/code/session_011hawTbuPyCwnEHaN7Us5tu
2026-10-17 Rod press holes 3.2 -> 3.3, 623ZZ pockets 10.2 -> 10.3
    Ten printed parts change: back_plate, front_plate, centre_wheel, strike_cam,
    third_wheel, escape_wheel, anchor, cannon_pinion, collar_x2, pendulum_hanger.
    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
2026-10-17 Running holes on phi3 rods 3.5 -> 3.6
    Five printed parts change: great_wheel, drum_core, drum_front, minute_wheel, hammer.
    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
2026-10-17 Split the bob and the pendulum hanger into glued halves
    The horizontal holes (pendulum rod, hanger clamp screw) needed support material that was
    hard to remove. Both parts are now split at the plane through those hole axes; each half
    prints split face up, so the holes become open grooves with no overhang. Two pegs on the
    rear half locate the front half for gluing. Assembled shape and hole sizes are unchanged.
    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
2026-10-21 Holes from the K1 / Hyper PLA-CF test assembly; winding hole in the dial
    - Rod press holes 3.3 -> 3.45 and 623ZZ pockets 10.3 -> 10.4 (K1 prints small holes
    0.3-0.7 mm under size; 3.3 and 10.3 were still too tight, 3.6 running holes were fine).
    - Fit test coupon (cad/extras, source/fit_test.py): press holes 3.35-3.55, pockets 10.30-10.50.
    - Winding: the key boss cut 2.5 mm into the dial ring and the handle ran 0.6 mm over the
    marks. Added a 22 mm winding hole at 6 o'clock and lengthened the key boss 22 -> 29 mm so
    the handle turns in front of the dial and hands.
    Claude-Session: https://claude.ai/code/session_011hawTbuPyCwnEHaN7Us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
2026-10-22 Peg holes of the bob and hanger halves 3.2 -> 3.6
    The printed phi-3 pegs did not go into the phi-3.2 holes on the K1. Use the running-hole size
    (3.6), which worked for the phi-3 rod. Only bob_front and pendulum_hanger_front change.
    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
2026-10-23 Rod press holes 3.45 -> 3.4
    3.45 was too loose for a press fit on the K1 / Hyper PLA-CF.
    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
2026-10-23 Shorter press on the anchor; wider M4 holes on the pendulum
    - Anchor: the 27 mm press along the whole bore was too tight. Press only in the pallet body
    (6 mm, 3.4), relieve the hub to 3.6.
    - Pendulum M4 holes +0.2: rod into the hanger 3.5 -> 3.7, bob 4.8 -> 5.0, rating nut 4.6 -> 4.8.
    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
2026-10-23 Hooked ratchet and a lower great-wheel ratio (72/12 -> 63/21)
    After assembly the drum ratchet slipped backwards and a 1 kg weight
    could not turn the escape wheel.
    - Ratchet teeth undercut 12 deg (load pulls the pawls in), 3.0 mm deep;
    pawls follow the undercut, spring arms 1.8 mm wide.
    - Great wheel 63 / centre pinion 21 at the same 63 mm centre distance:
    twice the torque at the escape wheel; run time about 27 h.
    - Centre-wheel pockets start outside the larger pinion (no overhang).
    - Changed parts: great_wheel, centre_wheel, drum_core, click_plate.
    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
2026-10-26 Larger drum, 60/24 gears, and a more forgiving escapement
    Keeps at least 24 h of running and at most 1.5 m of drop.
    - Drum r 20 -> 23.5 (cord radius 24), flanges r 27.5; great wheel 60 /
    centre pinion 24 at the same centre distance. The weight now falls
    60.3 mm/h (was 42.9): 1.41x the torque at the escape wheel; 9.8 turns,
    1.49 m, about 24.5 h.
    - Escapement: lift 3 -> 2 deg (let-off amplitude 2.25 -> 1.75 deg), drop
    2 -> 2.25 deg, tooth back radial for its top 1.2 mm. The 2D cycle now
    works with the wheel 0.18 mm and the anchor 0.12 mm oversize or
    undersize; before, 0.1 mm oversize jammed it (entry pallet corner
    against the back of the tooth that had just dropped).
    - sim_const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
2026-10-26 Pendulum hanger: rod hole 3.7 -> 3.9
    The M4 threaded rod still went into the hanger too hard; the screw-in hole
    is another 0.2 mm wider. Changed parts: pendulum_hanger_rear and
    pendulum_hanger_front.
    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
2026-10-28 Escapement that does not run through; drum screw holes; more backlash
    After fitting the 10-26 anchor and escape wheel the wheel ran through.
    The top 1.2 mm of those teeth was 0.3-0.5 mm wide, thinner than one
    extrusion line, so the tips printed short and the 0.8 mm lock was lost.
    - Tooth top 0.8 mm wide down to the knee (land 0.8, undercut 4 deg,
    back above the knee 4 deg); lock 1.5 -> 2.0 deg, drop 2.25 -> 2.75 deg.
    2D check: works with the anchor 0.3 mm nearer / 0.4 mm further than
    designed, with tips 0.2 mm short, and 0.08/0.05 mm oversize.
    - extras/anchor_deep_0.2, anchor_deep_0.4, anchor_shallow_0.2: spare
    anchors laid out for a different centre distance, for fitting by hand.
    -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
2026-10-29 Pendulum hanger: rod hole 3.9 -> 4.5
    As asked. The M4 rod now slides in and is held by the nut tightened
    against the underside of the hanger (glue if it wobbles). The lower
    locating peg moves 0.4 mm outward to keep a 1.15 mm wall to the wider
    groove. Changed parts: pendulum_hanger_rear, pendulum_hanger_front.
    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
2026-11-02 Escapement lock 2.0 -> 1.75 deg
    The clock ran but stopped after about 30 s: with dips in the drive the
    swing did not reach let-off and a tooth tip was left on the pallet's
    let-off corner. Let-off 2.0 -> 1.875 deg, about 18 % less energy per
    beat; the 2D window stays -0.3 .. +0.4 mm. Only the anchor (and the
    three spare anchors) change; the escape wheel keeps its shape.
    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
2026-11-04 Split-clamp pendulum hanger; bearing faces touch the inner ring only
    The clock ran about a minute and then the swing died away; a heavier
    weight and silicone spray made little difference, which points to losses
    on the pendulum side or to parts rubbing.
    - Pendulum hanger split left/right through the plane holding both the
    anchor arbor and the pendulum rod; three M3x20 screws clamp both rods
    across a 0.5 mm gap (was a single slit clamp and a loose 4.5 mm rod
    hole, glued front/back halves). Block 3.5 mm deeper toward the wall.
    - Every face that runs against a 623ZZ now has a 4.6 x 0.6 mm shoulder.
    The 5.4 mm spacer ends and the 8 mm hubs of the anchor and the strike
    cam reached past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
2026-11-04 Escapement: lift and lock 1.5 deg, tooth undercut 12 deg
    With the 4 deg undercut the pallet's locking corner passed only
    0.005-0.017 mm from the tooth front during the supplementary arc; 12 deg
    gives 0.07-0.09 mm (tooth top still 0.8 mm wide). Lift 2.0 -> 1.5 and
    lock 1.75 -> 1.5 deg bring let-off to 1.5 deg: about 36 % less energy
    per beat (17 % in the friction-free simulation). 2D window -0.2 .. +0.5
    mm (-0.3 .. +0.2 with tips 0.2 mm short); oversize/undersize still work.
    Changed: anchor (and spare anchors), escape_wheel.
    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
